CodeClubTeam/ElectricGarden/README.md

# ElectricGarden

The repositories folder includes all of the files and repos that were created as part of the Electric Garden Project. Some folders include depreciated code that was no longer used in the final stage of the product.
