CodeClubTeam/ElectricGarden/Repositories/electricgarden-electricgardenfirmware-3cf1cbd7a6ae/provisioning/README.md

Provisioning for Electric Garden node devices
====================

Before the provision script can be run, Python is required to be installed, with Python 3 being used for most cases. The 'Add to PATH' option should be ticked when installing to allow for scripting.
Upon install and adding python to PATH, the `install.bat` file can be run to install all required modules.

Running the `deploy_node_fast_***_prod.bat` batch file (with *** being either G01 or L01 depending on which device is being provisioned) will begin the provisioning process for a node, if connected via the 6-pin FTDI USB cable.
Once plugged in with the black cable side being aligned with the '\*' symbol on the board, the COM port needs to be found, which can be found on windown devices checking the COM port items in device manager.
Editing the batch file will allow the change of the COM port that is being used if required.

Other arguments in the batch file include:
	
	-k or --key : LoRa Encryption key
	-r or --rom : Firmware ROM image to program
	-i or --image: Software FS image to program
	-c or --copy: Copy files to filesystem instead
	-q or --quiet: Do not show DEBUG messages
	-qq or --silent: Do not show INFO messages
	-qqq or --shutup: Do not show any logging

To change the software that is being installed on to the board, changes need to be made to the `***firmware.gz` file in the `artifacts` folder, where G01 and L01 firmware is separate.

If a device has been created in ThingPark before the provisioning process, the ThingPark reference value will not be returned correctly and the deployer will not add the reference.
In this case, the device can be removed from ThingPark and the process can be started, allowing the reference value to be saved to the database. 
This reference value is used by the ThingPark API to update the individual devices' information, such as the connectivity plan. The connectivity plan is initially set to None, to be changed later in the process when assigned to a user.

The 4-pin FTDI cable can be used to then check if the unit is working correctly. Once plugged in and the serial output is viewed, the normal code should run, connecting to the network and sending a data packet. Failure to connect or send is shown in the output.
