CodeClubTeam/ElectricGarden/Repositories/electricgarden-eg-device-hq-9bbac4f2906a/api/funcs/auditlog-inserter/README.md

# Audit log inserter

Takes messages from the audit log queue and inserts
them into the `auditlog` table.
