CodeClubTeam/ElectricGarden/Repositories/electricgarden-eg-device-hq-9bbac4f2906a/api/funcs/bootups-catm1/README.md

# Bootup (phone home) API

This is used as an http endpoint for catm1 devices on start up
to let us know they are still alive and what version of hardware and firmware they are running.

It sends them onto the event hub for later processing.
