CodeClubTeam/ElectricGarden/Repositories/electricgarden-eg-device-hq-9bbac4f2906a/api/funcs/bootups/README.md

# Bootup Inserter

Takes the bootup messages off the queue and stores them into blob storage for retrieval.
