CodeClubTeam/ElectricGarden/Repositories/electricgarden-eg-device-hq-9bbac4f2906a/api/funcs/counters-catm1/README.md

# Catm1 counters receiver

This is used as an http endpoint for catm1 devices to send their counters when
requested.

## Future work

We need to have a handler that listens to the counters queue and runs same logic
in this handler to persist them.
