CodeClubTeam/ElectricGarden/Repositories/electricgarden-eg-device-hq-9bbac4f2906a/api/funcs/counters-inserter/README.md

# Counters inserter

Takes counters from the countersQueue (will have been fed from both lora and catm1)
and writes them to azure table storage
