CodeClubTeam/ElectricGarden/Repositories/electricgarden-eg-device-hq-9bbac4f2906a/api/funcs/device-default-settings/README.md

# Device Default Settings API

API for retrieving and updating default settings for each device type.
