CodeClubTeam/ElectricGarden/Repositories/electricgarden-eg-device-hq-9bbac4f2906a/api/funcs/error-relay/README.md

# Errors Inserter

This listens to the errors queue, tweaks and sends them on to raygun.
