CodeClubTeam/ElectricGarden/Repositories/electricgarden-eg-device-hq-9bbac4f2906a/api/funcs/errors-catm1/README.md

# Errors API

This is used as an http endpoint for catm1 devices to send their errors when
requested.
