CodeClubTeam/ElectricGarden/Repositories/electricgarden-eg-device-hq-9bbac4f2906a/api/funcs/lora-sendtime/README.md

# Lora Send Time

Process Send Time messages, delivering them to target device via Thing Park.
