CodeClubTeam/ElectricGarden/Repositories/electricgarden-eg-device-hq-9bbac4f2906a/api/funcs/message-pump/README.md

# Message Pump

This handler is purely to take messages off the Event Hub and route them to the appropriate
Azure storage queue for processing.

For samples, it splits them up into one message for each sample
so each is handled independently (e.g. in retries etc).
