CodeClubTeam/ElectricGarden/Repositories/electricgarden-eg-device-hq-9bbac4f2906a/api/funcs/sample-metrics-updater/README.md

# Sample Metrics updater

Takes sample messages from the sample metrics queue
and updates the samplemetrics table accordingly.
