CodeClubTeam/ElectricGarden/Repositories/electricgarden-eg-device-hq-9bbac4f2906a/api/funcs/sample-relay-multi-delivery/README.md

# Sample Relay Multi Delivery

Handle for the multi-delivery queue that simply relays
samples to the endpoint specified in the queue item.

Used for multi-delivery to ensure each sample endpoint is retried independently.
