CodeClubTeam/ElectricGarden/Repositories/electricgarden-eg-device-hq-9bbac4f2906a/api/funcs/sample-relay-settings/README.md

# Sample Relay Settings API

API for retrieving and updating sample relay end point for each device type.
