CodeClubTeam/ElectricGarden/Repositories/electricgarden-eg-device-hq-9bbac4f2906a/api/funcs/counters/post/README.md

# Counters POST API

This used to be for devices to send to but now they send to catm1-counters.

This is more for testing with a nice json payload directly without the queue.
