CodeClubTeam/ElectricGarden/Repositories/electricgarden-eg-app-e531e8d42cab/ui/src/lessons/content/examples/basics/features-example.mdx

---
name: features-example
title: Features Example
level: 90
publish: localdev
locked: false
---

import { Button } from '../../../../atomic-ui';

## Demo Content

Alan's demo activity to show what can be done with content in the publishing platform.

## Markdown Demo

### Unordered List

-   One
-   Yes

### Numbered List

1.  one
2.  two
3.  aefe

### Formatting

**italics**

~~strikethrough~~

### Block quote:

> more text please

### Some code:

```javascript
function myFun() {
    return 2;
}
```

### Table

| col 1 | col 2 | col 3 | col 4 |
| --- | --- | :---: | ---: |
| spindly bike | hairy legs | cold southerly | exposed ridgeline |

---

## Custom Activity Demo

### Button

This is an actual button as used in the Electric Garden app.
If the implementation of that button changes, so will it.

<Button>Click Me!</Button>
<br />

You can use JSX attributes too.

For example, for a disabled button:

<Button disabled>Disabled Button</Button>
