CodeClubTeam/ElectricGarden/Repositories/electricgarden-eg-app-e531e8d42cab/ui/src/lessons/content/term1-kaitiakitanga/2software2/giants-k10-term1/giantst1s10.mdx

---
name: session10
title: Session 10 - Pruning Pumpkins
ordinal: 10
level: 3
type: giants-guide
term: 1
locked: false
publish: production
coverImagePath: ./gcs10.png
# badges:
#     required: Gardener
#     earned:
#         - Growing your first vegetable
---

import {
    MatchingActivity,
    MatchTarget,
    CannedChart,
    Para,
    MultiChoiceActivity,
    Image,
    ImageWithText,
    TextBox,
    Box,
    CollapsablePanel,
    Spreadsheet,
    Captioned,
    Figure,
    RoundImage,
    ImageWithBorder,
    GoogleDocs,
    GoogleSlides,
} from '../../../../activities';

import { Button } from '../../../../../atomic-ui';

import button from './docbutton.png';

##

###

<Figure>
    <h3>
        <b>Session 10 - Slide Deck</b>
    </h3>
</Figure>

<GoogleSlides
    googleId="2PACX-1vTvl3KjYVqWA8ZQ7ycDG64F3sq7TgafGjBnNhHZp_D1JRpGFeFhK0YiiJcIP9lwZc4BXuSqNf1ooUmQ"
    googlePdfId="1cpKZhSiLtOwhcXv2rZReMeaJxxmlKnTLFvNPi9s_w8k"
/>

<Figure>
    <h6>
        Click the <b>three dots</b> for the options menu, and select{' '}
        <b>'Enter Full Screen'</b> to present the lesson slides.
    </h6>
</Figure>

<br />

<hr />

<br />

###

<Figure>
    <h3>
        <b>Session 10 - Teacher Support</b>
    </h3>
</Figure>

<Figure>
    <a
        href={
            'https://docs.google.com/document/d/10E2sda29PJRIBYY-acljywu89zfQ-WiFnE-5OQzYP5k/preview'
        }
        target={'_blank'}
    >
        <ImageWithBorder src={button} />
    </a>
</Figure>

<br />

<Figure>
    <h6>
        Click the <b>button</b> to access the support document with detailed
        comments to guide the delivery of each slide.
    </h6>
</Figure>

<br />
<br />
<br />
