CodeClubTeam/ElectricGarden/Repositories/electricgarden-eg-app-e531e8d42cab/ui/src/lessons/content/term1-kaitiakitanga/7spreadsheets7/giants-k7-term4/giantst4s7.mdx

---
name: session7
title: Session 7 - Input & Output Devices
ordinal: 10
level: 3
type: giants-guide
term: 4
locked: false
publish: production
coverImagePath: ./gcs7.png
# badges:
#     required: Gardener
#     earned:
#         - Growing your first vegetable
---

import {
    MatchingActivity,
    MatchTarget,
    CannedChart,
    Para,
    MultiChoiceActivity,
    Image,
    ImageWithText,
    TextBox,
    Box,
    CollapsablePanel,
    Spreadsheet,
    Captioned,
    Figure,
    RoundImage,
    ImageWithBorder,
    GoogleDocs,
    GoogleSlides,
} from '../../../../activities';

import { Button } from '../../../../../atomic-ui';

import button from './docbutton.png';

##

###

<Figure>
    <h3>
        <b>Session 7 - Slide Deck</b>
    </h3>
</Figure>

<GoogleSlides
    googleId="2PACX-1vTA6bdGAR4tMWHoP6VCvq_hbAEyUsLs-uta6b1jSuEGp_NLDM7FwhtoAPHQvsRGwZikg45cYGUJ9ey6"
    googlePdfId="13H6Q56lZcNqfDS7mGAEvLOPJcg4DNiIz7fthvZUhSUc"
/>

<Figure>
    <h6>
        Click the <b>three dots</b> for the options menu, and select{' '}
        <b>'Enter Full Screen'</b> to present the lesson slides.
    </h6>
</Figure>

<br />

<hr />

<br />

###

<Figure>
    <h3>
        <b>Session 7 - Teacher Support</b>
    </h3>
</Figure>

<Figure>
    <a
        href={
            'https://docs.google.com/document/d/1OH-iBLDivXzNqAnmxr9wgEhzVn8OaUZpP7ohdrzdUG4/preview'
        }
        target={'_blank'}
    >
        <ImageWithBorder src={button} />
    </a>
</Figure>

<br />

<Figure>
    <h6>
        Click the <b>button</b> to access the support document with detailed
        comments to guide the delivery of each slide.
    </h6>
</Figure>

<br />
<br />
<br />
