CodeClubTeam/ElectricGarden/Repositories/electricgarden-eg_hardware_designs-144f18870407/pcb/probe-cable/cable-drawing.pdf

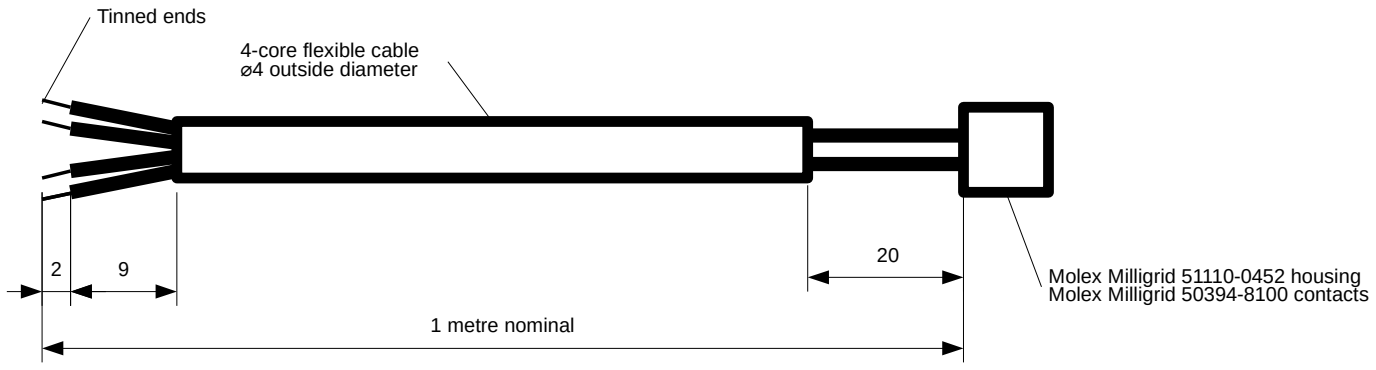
[picture p2: figure]
1 metre nominal; Molex Milligrid 51110-0452 housing Molex Milligrid 50394-8100 contacts; 4-core flexible cable ⌀4 outside diameter; Tinned ends

Electric Garden Probe Cable Specification
Dimensions are mm except where noted Prepared by
Stephen Irons
Brush Technology
2018-08-30
