CodeClubTeam/ElectricGarden/Repositories/electricgarden-eg_node_and_gateway_firmware-aa23058780e1/README.md

# CodeClub HTVG Project

For LoPy devices implementing LoRa, minimum firmware version supported is 1.15.0.b1

# 900MHz Range Increase 
SRD 915-928 MHz

STLs to please move out of 915-921 MHz to allow SRDs

https://www.rsm.govt.nz/about-rsm/spectrum-policy/gazette/gurl/short-range-devices

# Transmission limits
https://gazette.govt.nz/notice/id/2016-go6047

|Band|Max dbW e.i.r.p|Notes|
-|-|-
915-928|0|23
920-928|6|13,23

Note 13. Transmitters using e.i.r.p.s greater than 0 dBW (1 W) must employ frequency hopping or digital modulation techniques.

Note 23. The reference bandwidth for emissions is 100 kHz

# LoRaWAN AU915-928
AU915-928 is the LoRaWAN frequency standard used in Australia and New Zealand.

https://www.thethingsnetwork.org/wiki/LoRaWAN/Frequencies/Frequency-Plans#lorawan-frequencies_au915-928

Uplink:    
916.8 - SF7BW125 to SF10BW125    
917.0 - SF7BW125 to SF10BW125    
917.2 - SF7BW125 to SF10BW125    
917.4 - SF7BW125 to SF10BW125    
917.6 - SF7BW125 to SF10BW125    
917.8 - SF7BW125 to SF10BW125    
918.0 - SF7BW125 to SF10BW125    
918.2 - SF7BW125 to SF10BW125    
917.5 - SF8BW500    
    
Downlink:    
923.3 - SF7BW500 to SF12BW500    
923.9 - SF7BW500 to SF12BW500    
924.5 - SF7BW500 to SF12BW500    
925.1 - SF7BW500 to SF12BW500    
925.7 - SF7BW500 to SF12BW500    
926.3 - SF7BW500 to SF12BW500    
926.9 - SF7BW500 to SF12BW500    
927.5 - SF7BW500 to SF12BW500

This gives us the following unusued channels    
Below Uplink
