CodeClubTeam/ElectricGarden/Repositories/electricgarden-eg-app-e531e8d42cab/shop-ui/src/pages/product/eg-in-garden.jpg

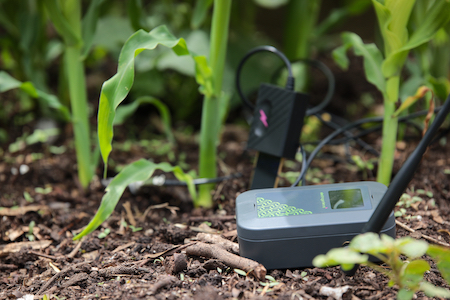
Repositories/electricgarden-eg-app-e531e8d42cab/shop-ui/src/pages/product/eg-in-garden.jpg
