CodeClubTeam/ElectricGarden/Repositories/electricgarden-eg-app-e531e8d42cab/shop-ui/src/pages/product/eg-open-box.jpg

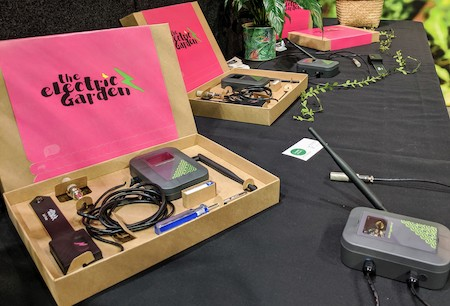
Repositories/electricgarden-eg-app-e531e8d42cab/shop-ui/src/pages/product/eg-open-box.jpg
