CodeClubTeam/ElectricGarden/Repositories/electricgarden-eg_hardware_designs-144f18870407/pcb/housing/TEG_BoxDecal-10_V2-10-10.png

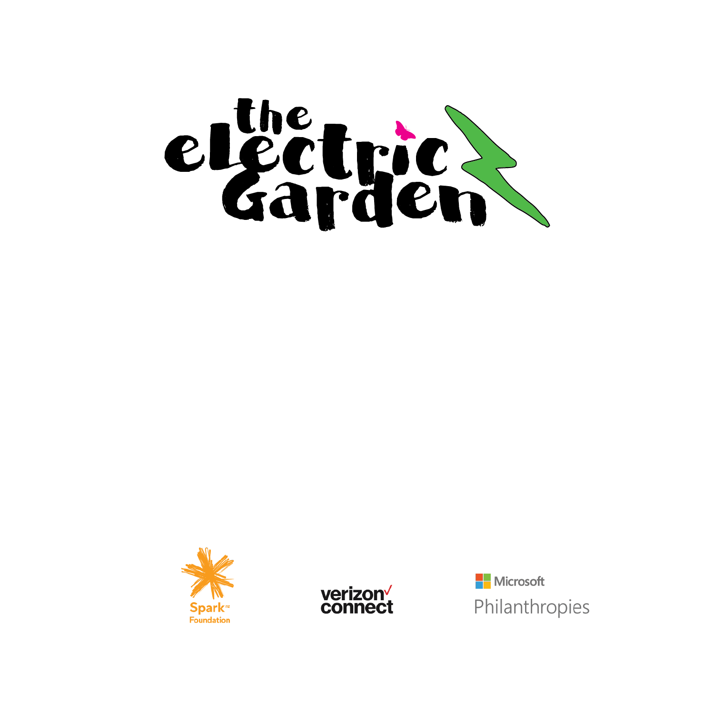
Repositories/electricgarden-eg_hardware_designs-144f18870407/pcb/housing/TEG_BoxDecal-10_V2-10-10.png
