CodeClubTeam/ElectricGarden/Repositories/electricgarden-eg_node_and_gateway_firmware-aa23058780e1/tools/research_development/spectral analysis of LTR329ALS/light-plot.PNG

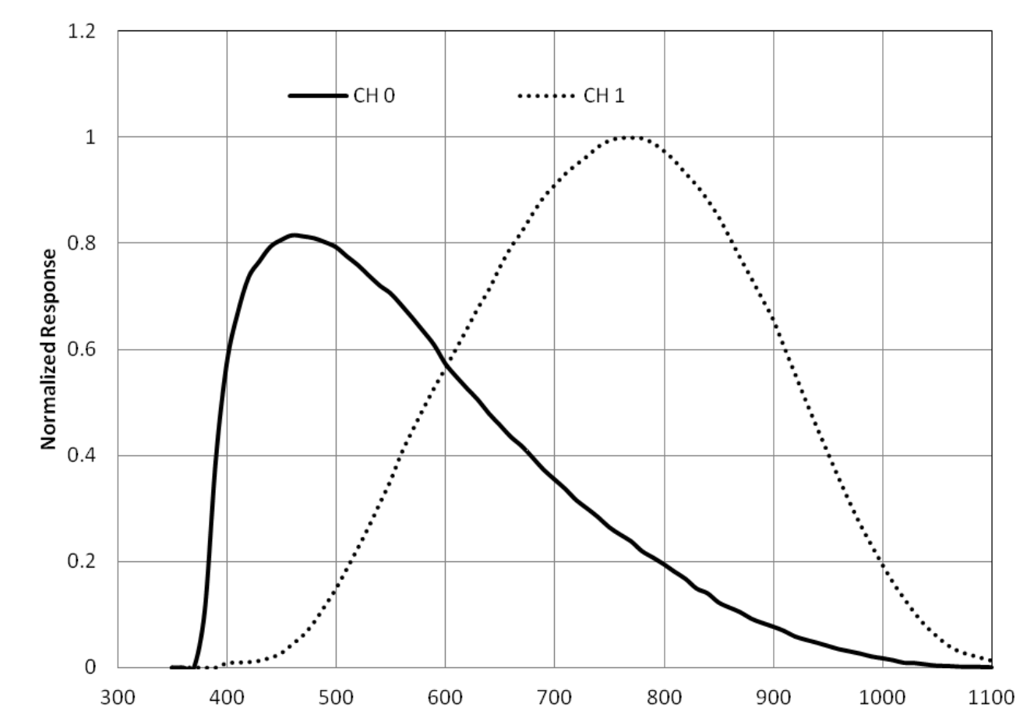
Repositories/electricgarden-eg_node_and_gateway_firmware-aa23058780e1/tools/research_development/spectral analysis of LTR329ALS/light-plot.PNG
