CodeClubTeam/ElectricGarden/Repositories/electricgarden-eg-app-e531e8d42cab/ui/src/lessons/content/examples/chart/chart-example-guide.mdx

---
name: chart-example1
title: Chart Example - Guide
type: facilitation-guide
publish: false
coverImagePath: ./images/chart-cover.png
---

## This is a teacher guide to the Chart Example

Cold wind and rain comes with storms and with that the temperature
drops and the moisture in the soil goes up.

In this lesson your students are encouraged to discover the relationship
between weather conditions and these metrics captured by Electric Garden sensors.
