CodeClubTeam/ElectricGarden/Repositories/electricgarden-eg_hardware_designs-144f18870407/pcb/housing/EG-node-machining.pdf

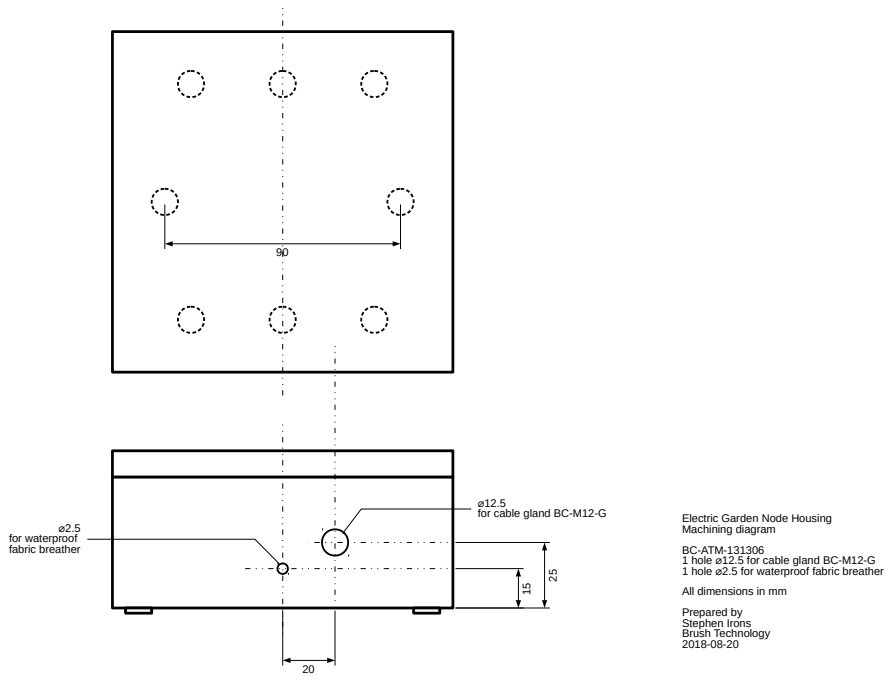
[picture p7: page 1]
⌀2.5 for waterproof fabric breather; for cable gland BC-M12-G; Electric Garden Node Housing

Machining diagram
BC-ATM-131306
1 hole ⌀12.5 for cable gland BC-M12-G
1 hole ⌀2.5 for waterproof fabric breather
All dimensions in mm
Prepared by
Stephen Irons
Brush Technology
