CodeClubTeam/ElectricGarden/Repositories/electricgarden-eg_hardware_designs-144f18870407/pcb/housing/EG-node-printing-black-127x127.pdf

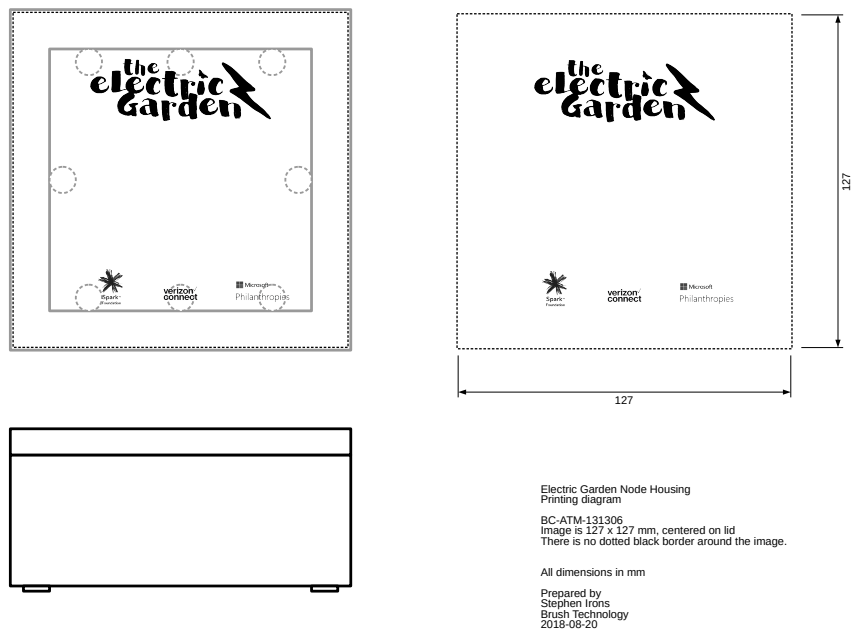
[picture p8: page 1]

Electric Garden Node Housing
Printing diagram
BC-ATM-131306
Image is 127 x 127 mm, centered on lid
There is no dotted black border around the image.

All dimensions in mm
Prepared by
Stephen Irons
Brush Technology
