CodeClubTeam/ElectricGarden/Repositories/electricgarden-eg_hardware_designs-144f18870407/pcb/housing/EG-node-printing.pdf

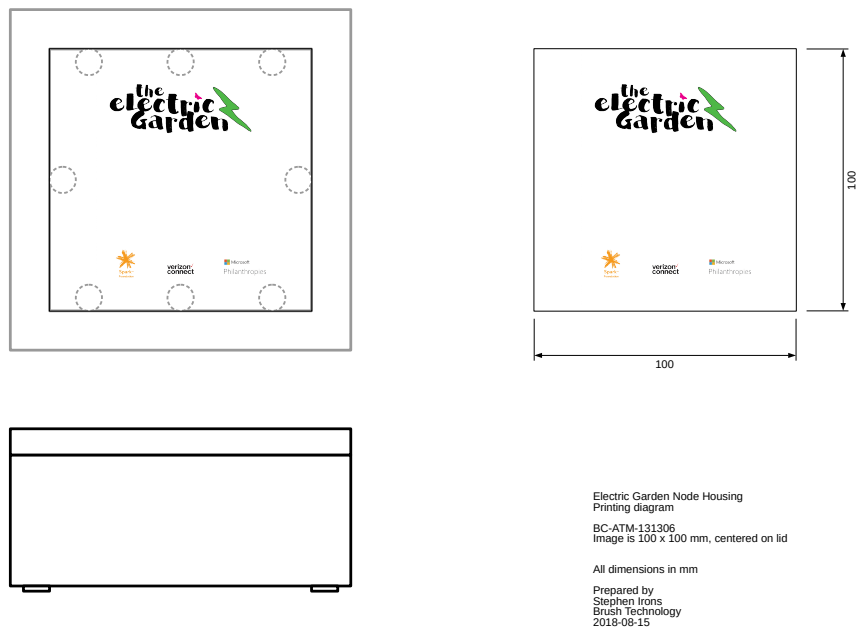
[picture p9: page 1]

Electric Garden Node Housing
Printing diagram
BC-ATM-131306
Image is 100 x 100 mm, centered on lid

All dimensions in mm
Prepared by
Stephen Irons
Brush Technology
