CodeClubTeam/ElectricGarden/Repositories/electricgarden-eg_hardware_designs-144f18870407/pcb/eg_node/v1.1.0/eg_node.pdf

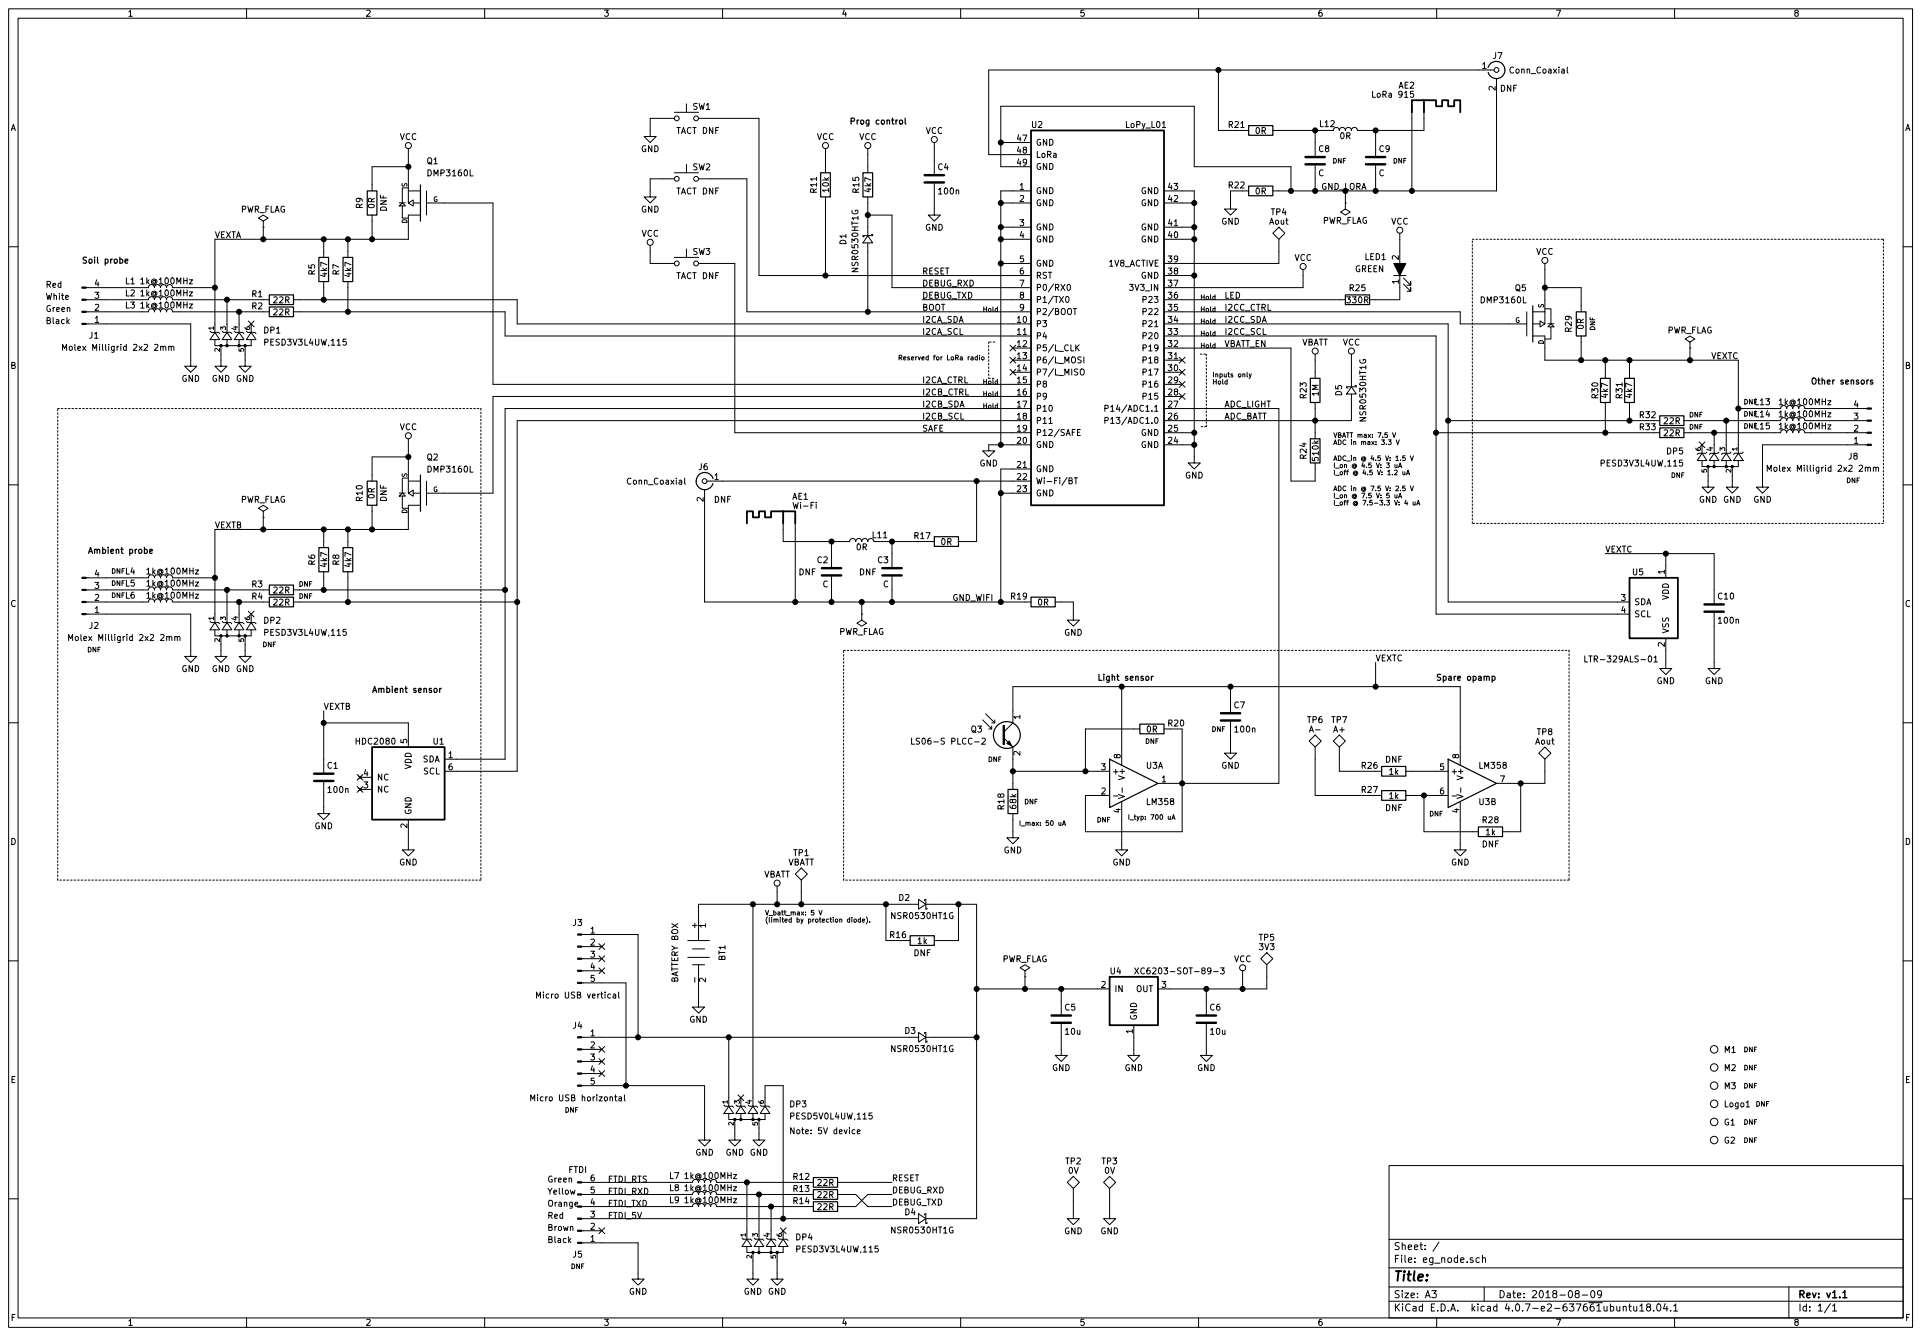
[picture p10: page 1]
