CodeClubTeam/ElectricGarden/Repositories/electricgarden-eg_hardware_designs-144f18870407/pcb/eg_probe/v0.1.4/eg_probe.pdf

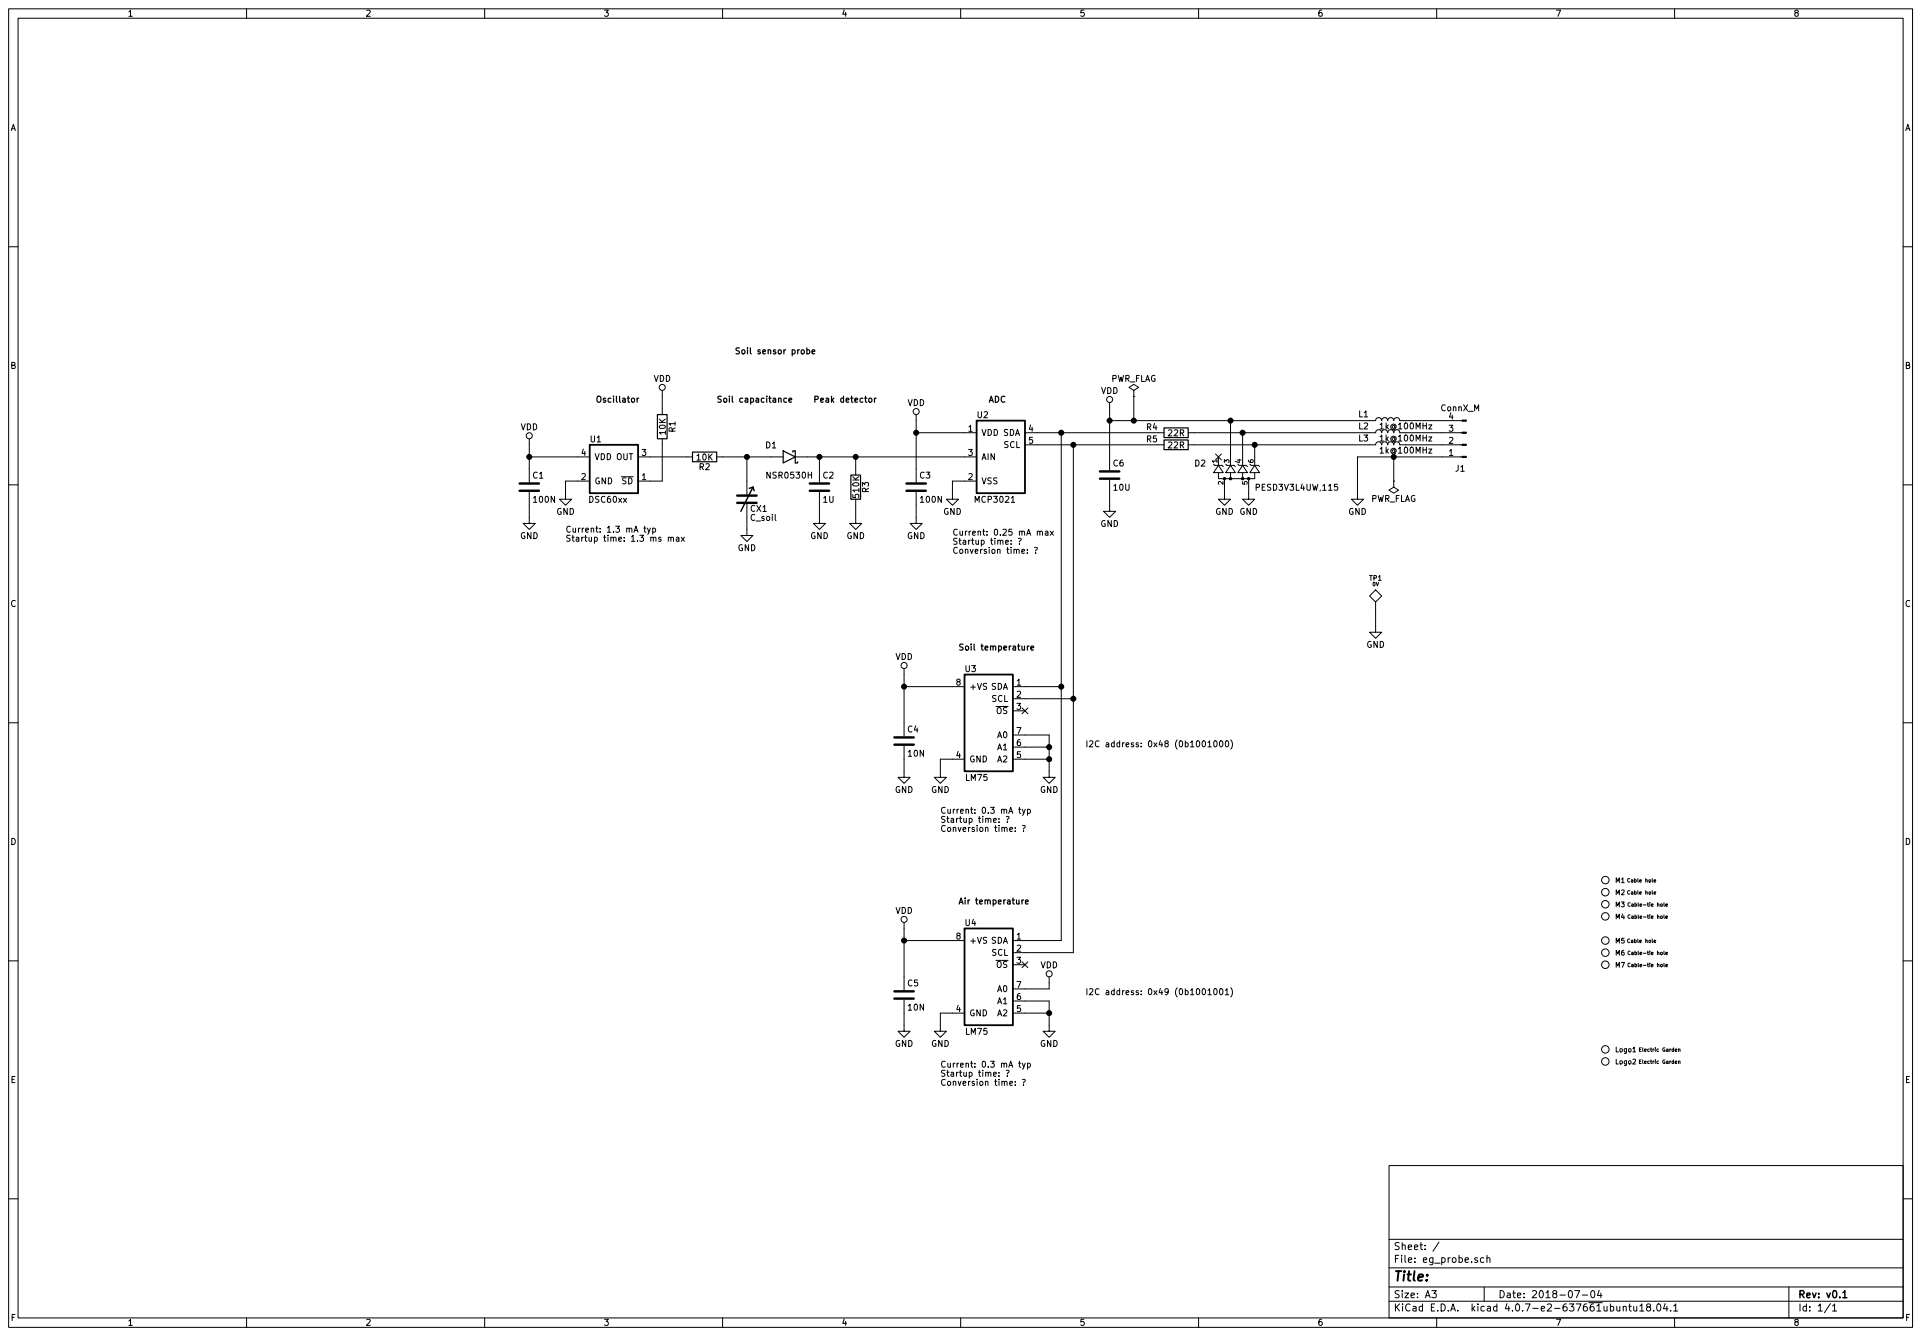
[picture p11: page 1]
