CodeClubTeam/ElectricGarden/Repositories/electricgarden-eg_hardware_designs-144f18870407/pcb/eg_node/v0.3.2/eg_node.pdf

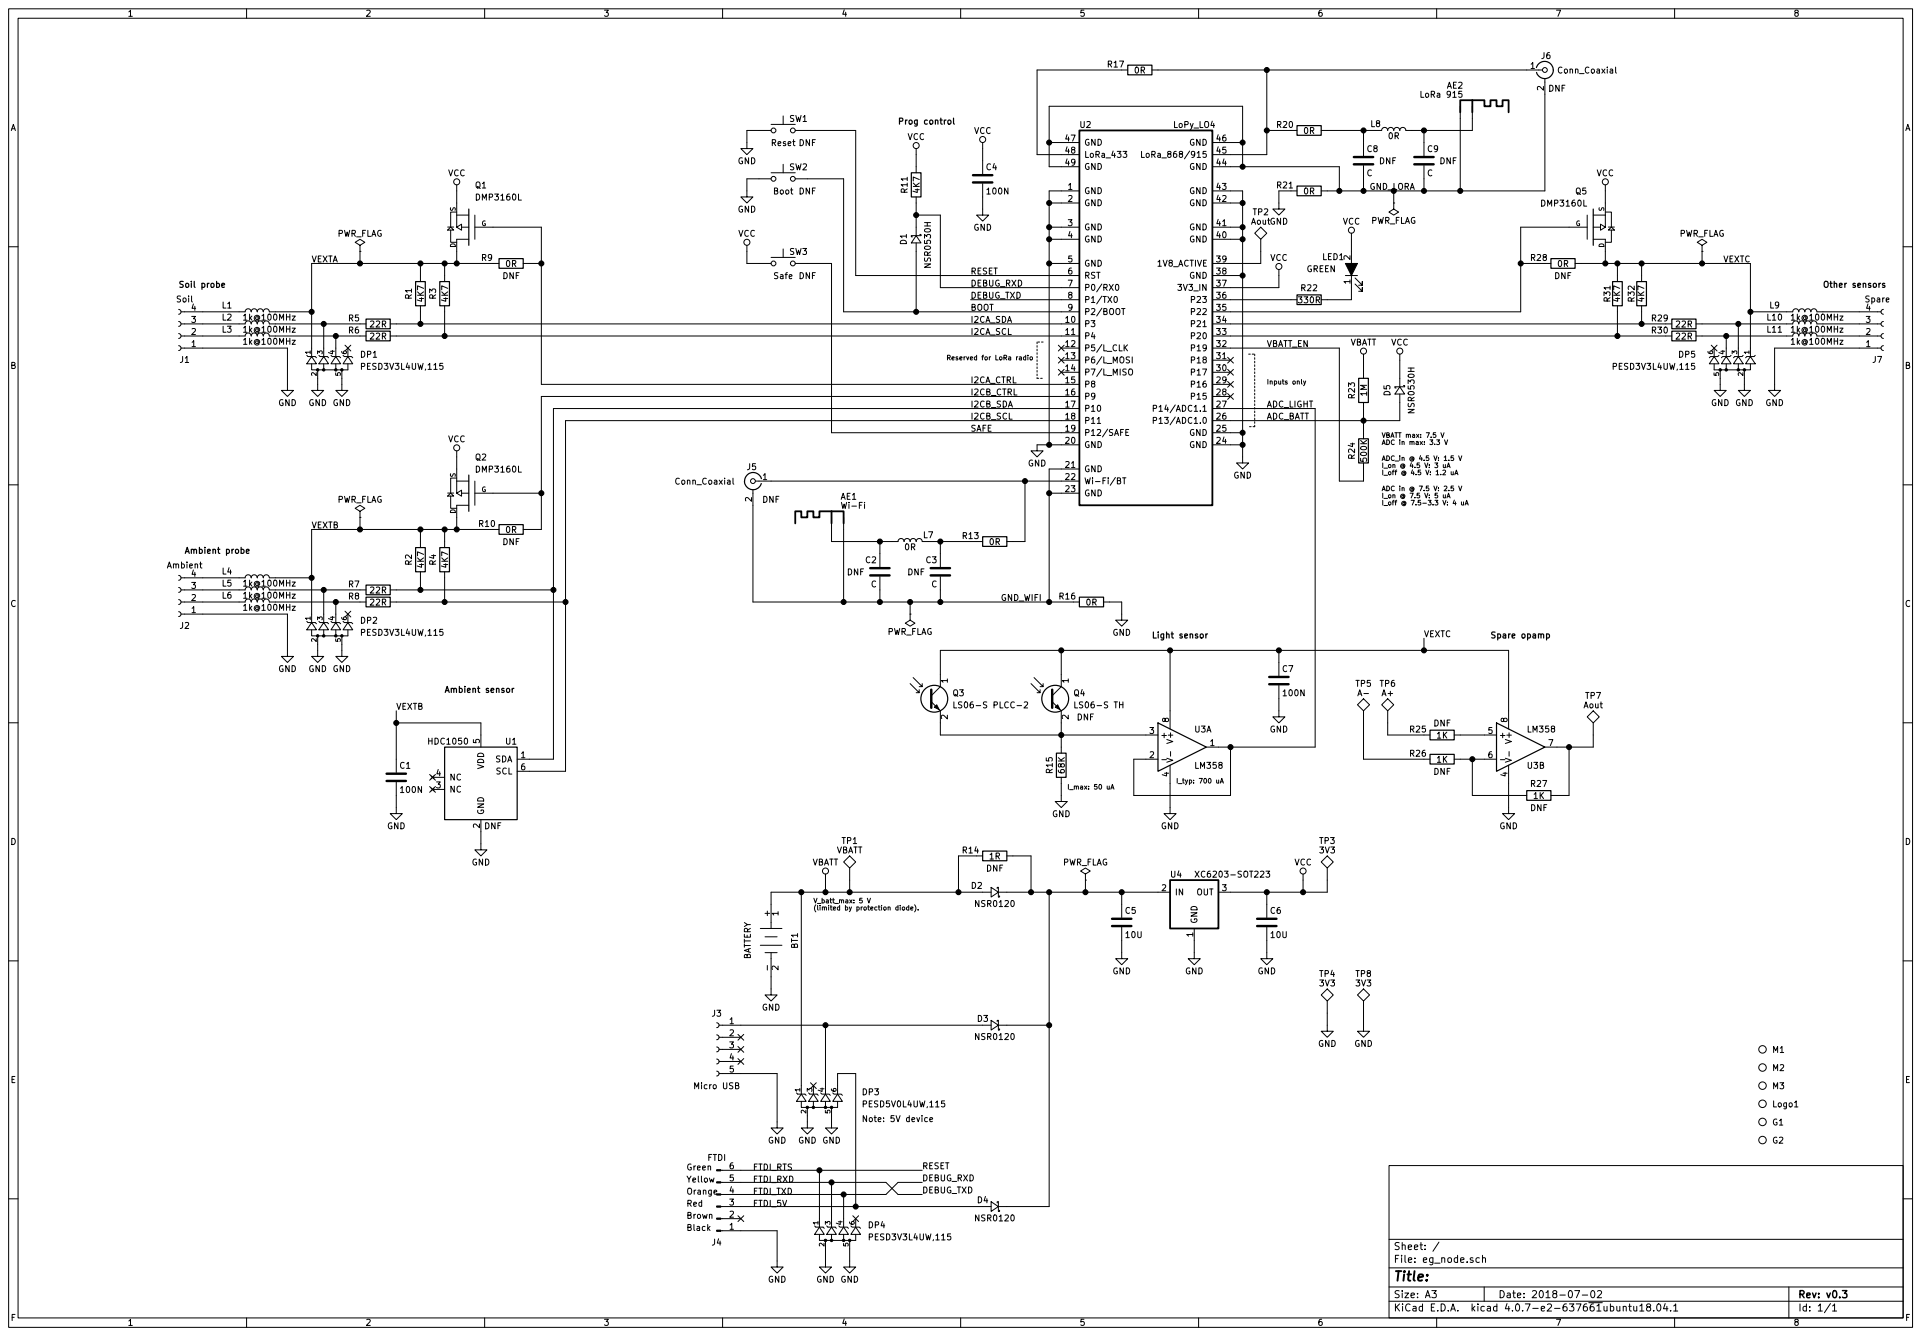
[picture p12: page 1]
