CodeClubTeam/ElectricGarden/Repositories/electricgarden-eg_hardware_designs-144f18870407/pcb/eg_node/eg_node.kicad_pcb

## KiCad design Repositories/electricgarden-eg_hardware_designs-144f18870407/pcb/eg_node/eg_node.kicad_pcb (2023-07-12)

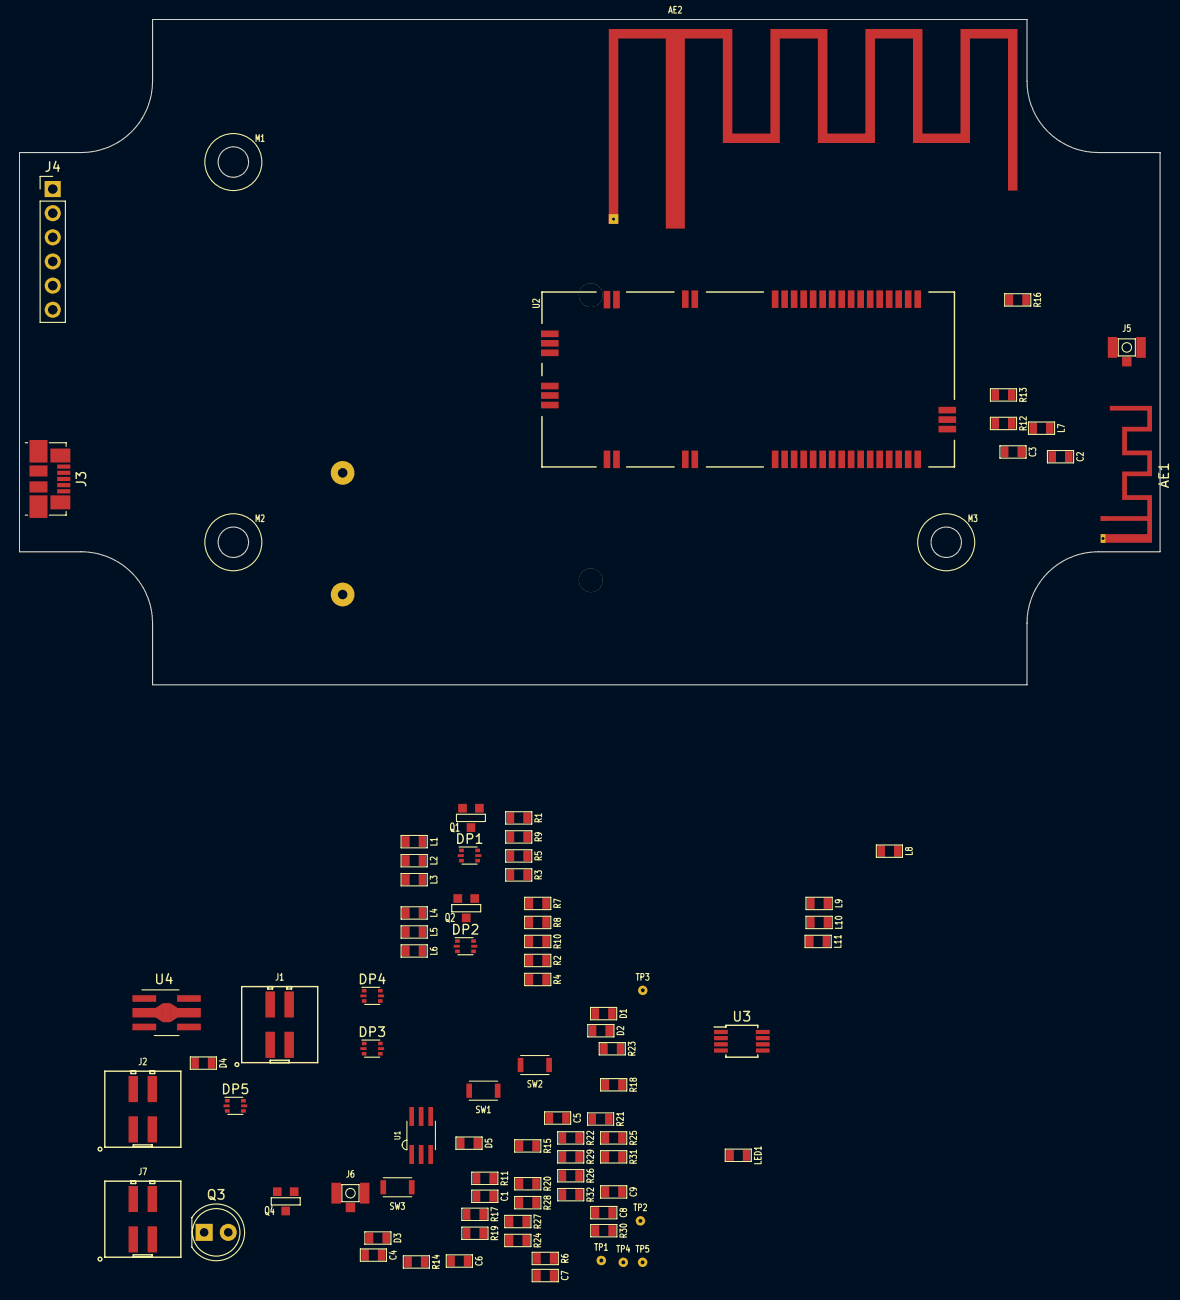
[picture p13: board eg_node.kicad_pcb from above]

Board: 4 copper layers, 120.0 x 70.0 mm, 92 parts (1 on the bottom side), 60 nets, no tracks yet.

Parts:
AE1: Antenna_F; Texas_SWRA117D_2.4GHz_Left
AE2: Antenna_F; Texas_SWRA228C_915MHz_Right
BT1: BATTERY; MPD_BC3AAPC
C1, C4, C7: 100N; SM0603
C2, C3, C8, C9: C; SM0603
C5, C6: 10U; SM0603
D1, D5: NSR0530H; SM0603
D2, D3, D4: NSR0120; SM0603
DP1, DP2, DP4, DP5: UCLAMP3304A; SOT-666
DP3: UCLAMP0504A; SOT-666
J1, J2, J7: ConnX_F; Molex_Milligrid_02x2_2mm
J3: Micro USB; USB_Micro-B_Molex_47346-0001
J4: FTDI; Socket_Strip_Straight_1x06_Pitch2.54mm
J5, J6: Conn_Coaxial; Hirose-U.FL-R-SMT-1(40)
L1, L2, L3, L4, L5, L6, L9, L10, L11: 1k@100MHz; SM0603
L7, L8: 0R; SM0603
LED1: GREEN; SM0603
M1, M2, M3: MOUNT; hole3.2
Q1, Q2, Q4: BSS308PE H6327; SOT23GDS
Q3: LS06-S; LED_D5.0mm
R1, R2, R3, R4, R11, R31, R32: 4K7; SM0603
R5, R6, R7, R8, R29, R30: 22R; SM0603
R9, R10, R12, R13, R16, R17, R18, R19, R20, R21, R28: 0R; SM0603
R14: 1R; SM0603
R15: 68K; SM0603
R22: 330R; SM0603
R23: 1M; SM0603
R24: 500K; SM0603
R25, R26, R27: 1K; SM0603
SW1: Reset; CK_KXT_3xx
SW2: Boot; CK_KXT_3xx
SW3: Safe; CK_KXT_3xx
TP1: VBATT; Testpoint-1mm-TH
TP2: 3V3; Testpoint-1mm-TH
TP3: A-; Testpoint-1mm-TH
TP4: A+; Testpoint-1mm-TH
TP5: Aout; Testpoint-1mm-TH
U1: HDC1050; WSON6
U2: LoPy_LO4; L04_OEM
U3: LM358; MSOP-8_3x3mm_Pitch0.65mm
U4: NCP694-SOT-895; SOT-89-5_Housing_Handsoldering

Connections:
/ADC_BATT: D5.2, R23.2, R24.1, U2.26
/ADC_LIGHT: U2.27, U3.1, U3.2
/BOOT: D1.2, SW2.2, U2.9
/DEBUG_RXD: D1.1, DP4.4, J4.4, R11.2, U2.7
/DEBUG_TXD: DP4.3, J4.5, U2.8
/GND_LORA: AE2.2, C8.2, C9.2, J6.2, R21.1, U2.44, U2.46, U2.47, U2.49
/GND_WIFI: AE1.2, C2.2, C3.2, J5.2, R16.2, U2.21, U2.23
/I2CA_CTRL: Q1.G, R9.1, U2.15
/I2CA_SCL: R6.1, U2.11
/I2CA_SDA: R5.1, U2.10
/I2CB_CTRL: Q2.G, R10.1, U2.16
/I2CB_SCL: R8.1, U1.6, U2.18
/I2CB_SDA: R7.1, U1.1, U2.17
/RESET: DP4.1, J4.6, SW1.2, U2.6
/SAFE: SW3.2, U2.19
/VBATT_EN: R24.2, U2.32
/VEXTA: DP1.1, L1.2, Q1.D, R1.1, R3.1, R9.2
/VEXTB: C1.1, DP2.1, L4.2, Q2.D, R2.1, R4.1, R10.2, U1.5
/VEXTC: C7.1, DP5.1, L9.2, Q3.1, Q4.D, R28.2, R31.1, R32.1, U3.8
GND: BT1.2, C1.2, C4.2, C5.2, C6.2, C7.2, DP1.2, DP1.5, DP2.2, DP2.5, DP3.2, DP3.5, DP4.2, DP4.5, DP5.2, DP5.5, J1.1, J2.1, J3.4, J4.1, J7.1, R15.2, R16.1, R21.2, SW1.1, SW2.1, U1.2, U2.1, U2.2, U2.3, U2.4, U2.5, U2.20, U2.24, U2.25, U2.38, U2.40, U2.41, U2.42, U2.43, U3.4, U4.2
unnamed: AE1.1, C2.1, L7.2
unnamed: AE2.1, C9.1, L8.2
unnamed: C3.1, L7.1, R13.2
unnamed: C5.1, D2.1, D3.1, D4.1, R14.1, U4.3, U4.4
unnamed: C8.1, L8.1, R19.1, R20.1
unnamed: D3.2, DP3.4, J3.1
unnamed: D4.2, DP3.6, J4.3
unnamed: DP1.3, L2.2, R1.2, R5.2
unnamed: DP1.4, L3.2, R3.2, R6.2
unnamed: DP2.3, L5.2, R2.2, R7.2
unnamed: DP2.4, L6.2, R4.2, R8.2
unnamed: DP5.3, L10.2, R29.2, R32.2
unnamed: DP5.4, L11.2, R30.2, R31.2
unnamed: J1.2, L3.1
unnamed: J1.3, L2.1
unnamed: J1.4, L1.1
unnamed: J2.2, L6.1
unnamed: J2.3, L5.1
unnamed: J2.4, L4.1
unnamed: J5.1, R12.2
unnamed: J6.1, R17.1, R18.1
unnamed: J7.2, L11.1
unnamed: J7.3, L10.1
unnamed: J7.4, L9.1
unnamed: LED1.1, R22.1
unnamed: Q3.2, R15.1, U3.3
unnamed: Q4.G, R28.1, U2.35
unnamed: R12.1, R13.1, U2.22
unnamed: R17.2, R19.2, U2.48
unnamed: R18.2, R20.2, U2.45
unnamed: R22.2, U2.36
unnamed: R25.1, U3.5
unnamed: R25.2, TP4.1
unnamed: R26.1, R27.2, U3.6
unnamed: R26.2, TP3.1
unnamed: R27.1, TP5.1, U3.7
unnamed: R29.1, U2.34
unnamed: R30.1, U2.33
VCC: C4.1, C6.1, D5.1, LED1.2, Q1.S, Q2.S, Q4.S, R11.1, SW3.1, TP2.1, U2.37, U4.5
VDD2: BT1.1, D2.2, DP3.1, R14.2, R23.1, TP1.1
