CodeClubTeam/ElectricGarden/Repositories/electricgarden-eg_hardware_designs-144f18870407/pcb/eg_probe/eg_probe.kicad_pcb

## KiCad design Repositories/electricgarden-eg_hardware_designs-144f18870407/pcb/eg_probe/eg_probe.kicad_pcb (2023-07-12)

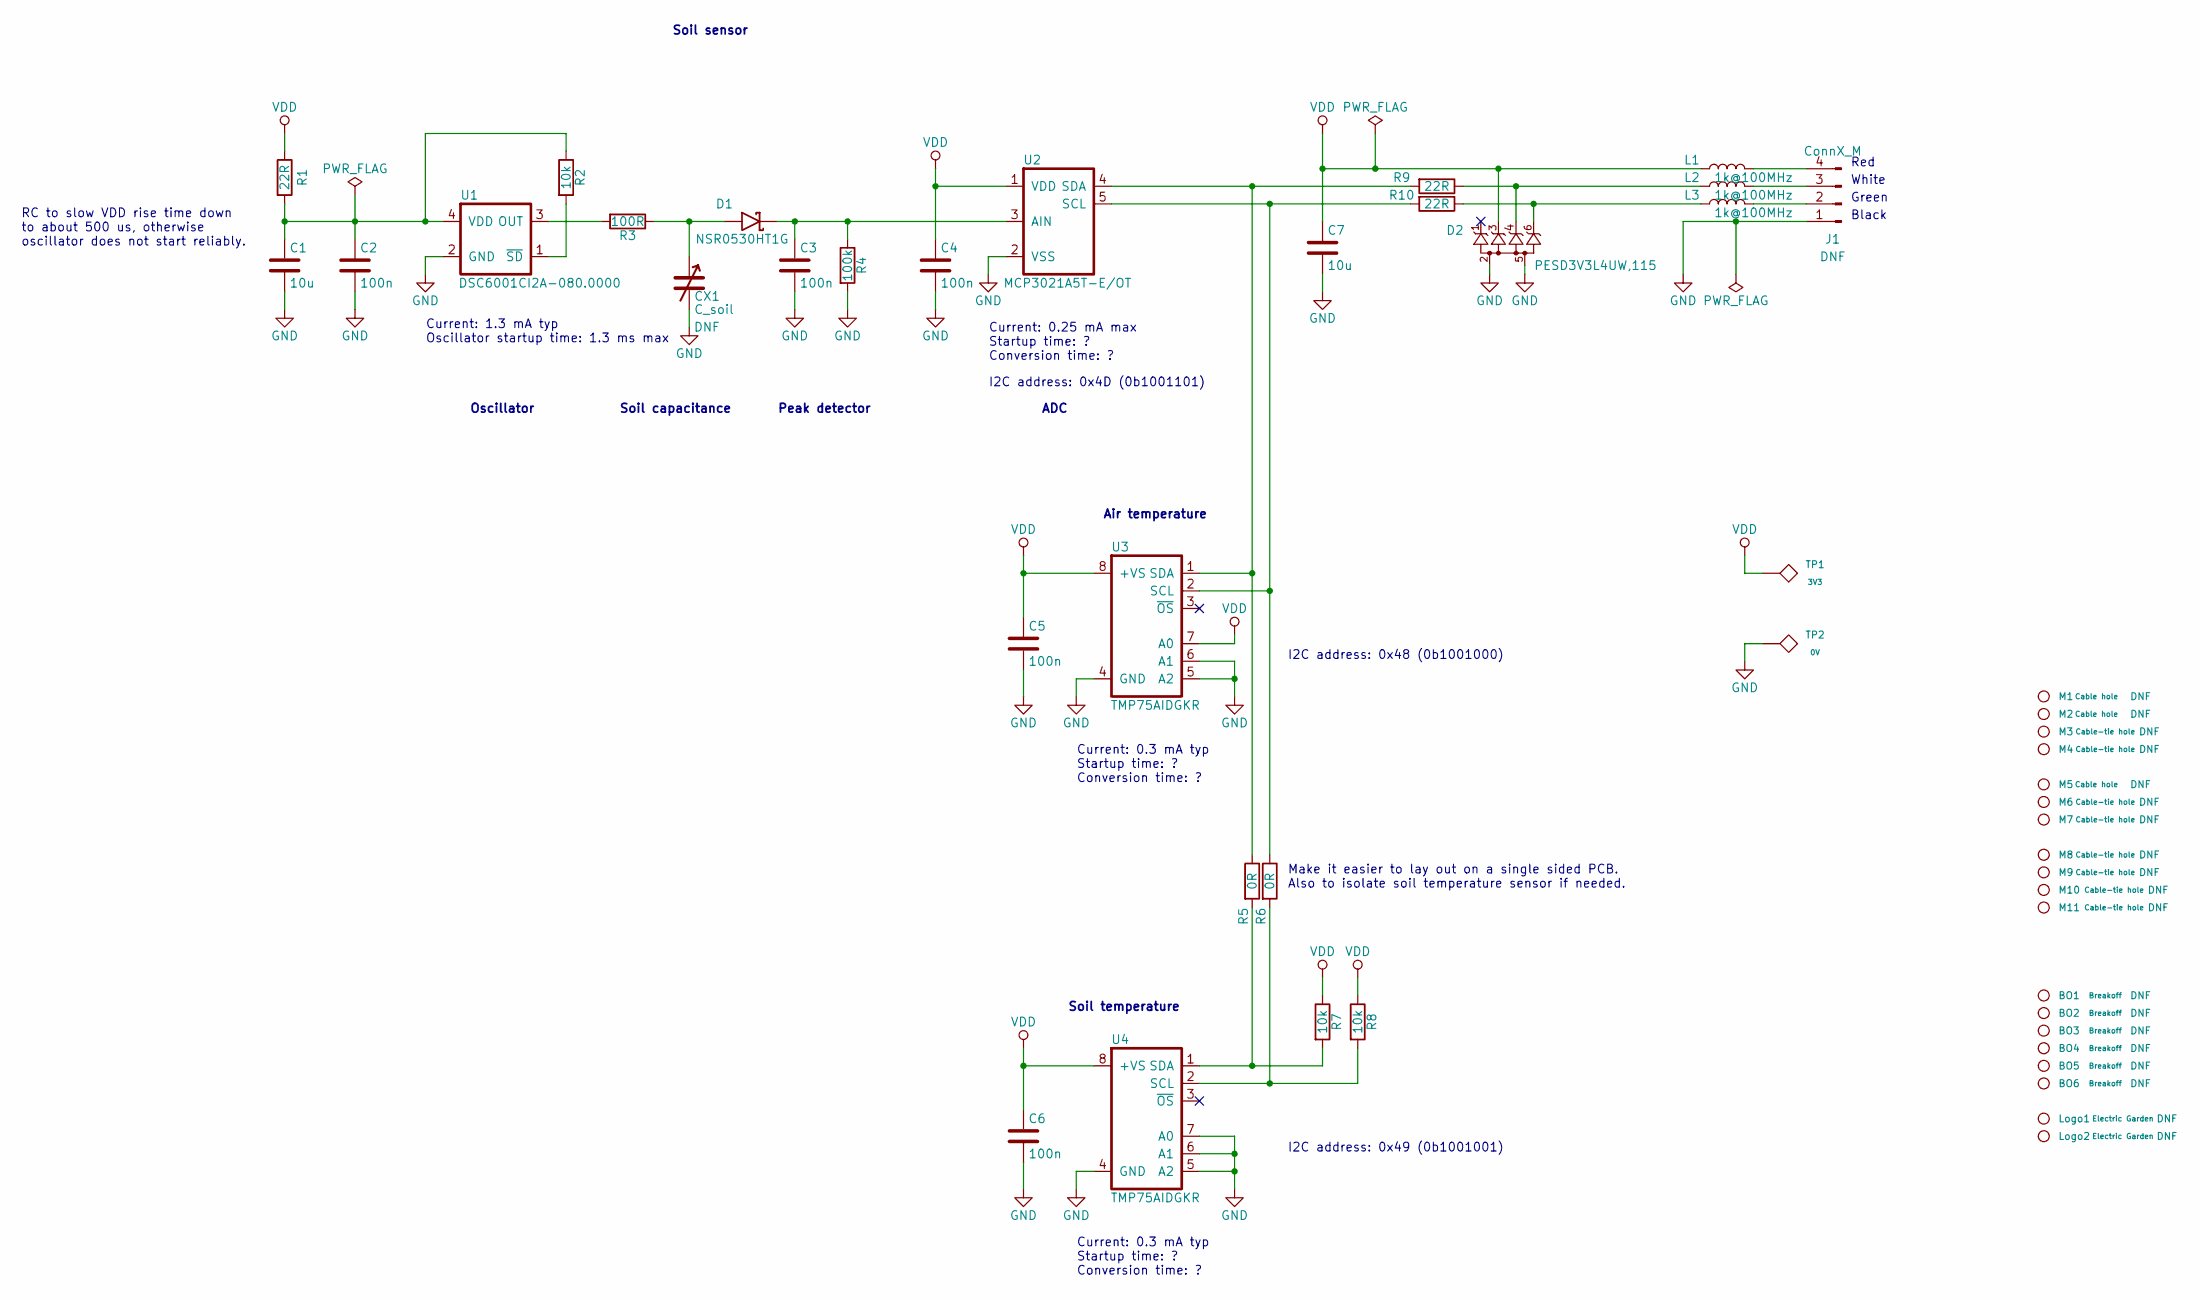
[picture p14: schematic eg_probe.sch]

Parts:
BO1, BO2, BO3, BO4, BO5, BO6: Breakoff; breakoff-2mm
C1, C7: 10u; SM0603
C2, C3, C4, C5, C6: 100n; SM0603
CX1: C_soil; Soil_sensor_capacitive
D1: NSR0530HT1G; D_SOD-323_HandSoldering; Part_number NSR0530HT1G
D2: PESD3V3L4UW,115; SOT-666; Part_number PESD3V3L4UW,115
J1: ConnX_M; CONN_SMD_1x4_big_pad
L1, L2, L3: 1k@100MHz; SM0603; Part_number BLM18AG102SN1D
Logo1: Electric Garden; logo-electric-garden-32x14
Logo2: Electric Garden; logo-electric-garden-25x11
M1, M2, M5: Cable hole; hole4.0
M3, M4, M6, M7, M8, M9, M10, M11: Cable-tie hole; hole3.2
R1, R9, R10: 22R; SM0603
R2, R7, R8: 10k; SM0603
R3: 100R; SM0603
R4: 100k; SM0603
R5, R6: 0R; SM0603
TP1: 3V3; TestPadSquare2.5mm
TP2: 0V; TestPadSquare2.5mm
U1: DSC6001CI2A-080.0000; DFN_4_32x25; Part_number DSC6001CI2A-080.0000
U2: MCP3021A5T-E/OT; SOT-23-5_HandSoldering; Part_number MCP3021A5T-E/OT
U3, U4: TMP75AIDGKR; S-PDSO-G8; Part_number TMP75AIDGKR

Connections:
GND: C1.2, C2.2, C3.2, C4.2, C5.2, C6.2, C7.2, CX1.2, D2.2, D2.5, J1.1, R4.2, TP2.1, U1.2 (GND), U2.2 (VSS), U3.4 (GND), U3.5 (A2), U3.6 (A1), U4.4 (GND), U4.5 (A2), U4.6 (A1), U4.7 (A0)
unnamed: C1.1, C2.1, R1.2, R2.1, U1.4 (VDD)
unnamed: C3.1, D1.2, R4.1, U2.3 (AIN)
unnamed: CX1.1, D1.1, R3.1
unnamed: D2.4, L2.1, R9.1
unnamed: D2.6, L3.1, R10.1
unnamed: J1.2, L3.2
unnamed: J1.3, L2.2
unnamed: J1.4, L1.2
unnamed: R2.2, U1.1 (~SD)
unnamed: R3.2, U1.3 (OUT)
unnamed: R5.1, R9.2, U2.4 (SDA), U3.1 (SDA)
unnamed: R5.2, R7.2, U4.1 (SDA)
unnamed: R6.2, R8.2, U4.2 (SCL)
unnamed: R6.1, R10.2, U2.5 (SCL), U3.2 (SCL)
VDD: C4.1, C5.1, C6.1, C7.1, D2.3, L1.1, R1.1, R7.1, R8.1, TP1.1, U2.1 (VDD), U3.7 (A0), U3.8 (+VS), U4.8 (+VS)

Notes on the sheet:
Peak detector
Soil capacitance
Oscillator
Soil sensor
Current: 1.3 mA typ Oscillator startup time: 1.3 ms max
ADC
Current: 0.25 mA max Startup time: ? Conversion time: ?
Air temperature
Current: 0.3 mA typ Startup time: ? Conversion time: ?
I2C address: 0x49 (0b1001001)
Red
White
Green
Black
Soil temperature
I2C address: 0x48 (0b1001000)
RC to slow VDD rise time down to about 500 us, otherwise oscillator does not start reliably.
Make it easier to lay out on a single sided PCB. Also to isolate soil temperature sensor if needed.
I2C address: 0x4D (0b1001101)

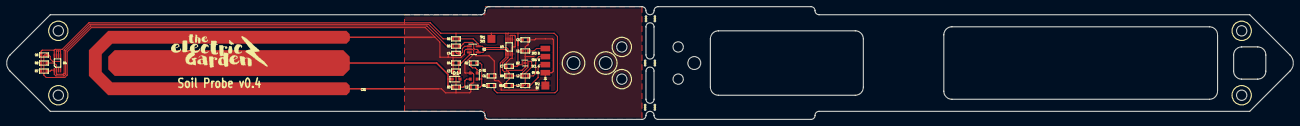
[picture p15: board eg_probe.kicad_pcb from above]

Board: 2 copper layers, 399.6 x 35.0 mm, 49 parts (4 on the bottom side), 16 nets.
