CodeClubTeam/ElectricGarden/Repositories/electricgarden-eg_hardware_designs-144f18870407/pcb/eg_node/eg_node+boxco-1313.kicad_pcb

## KiCad design Repositories/electricgarden-eg_hardware_designs-144f18870407/pcb/eg_node/eg_node+boxco-1313.kicad_pcb (2023-07-12)

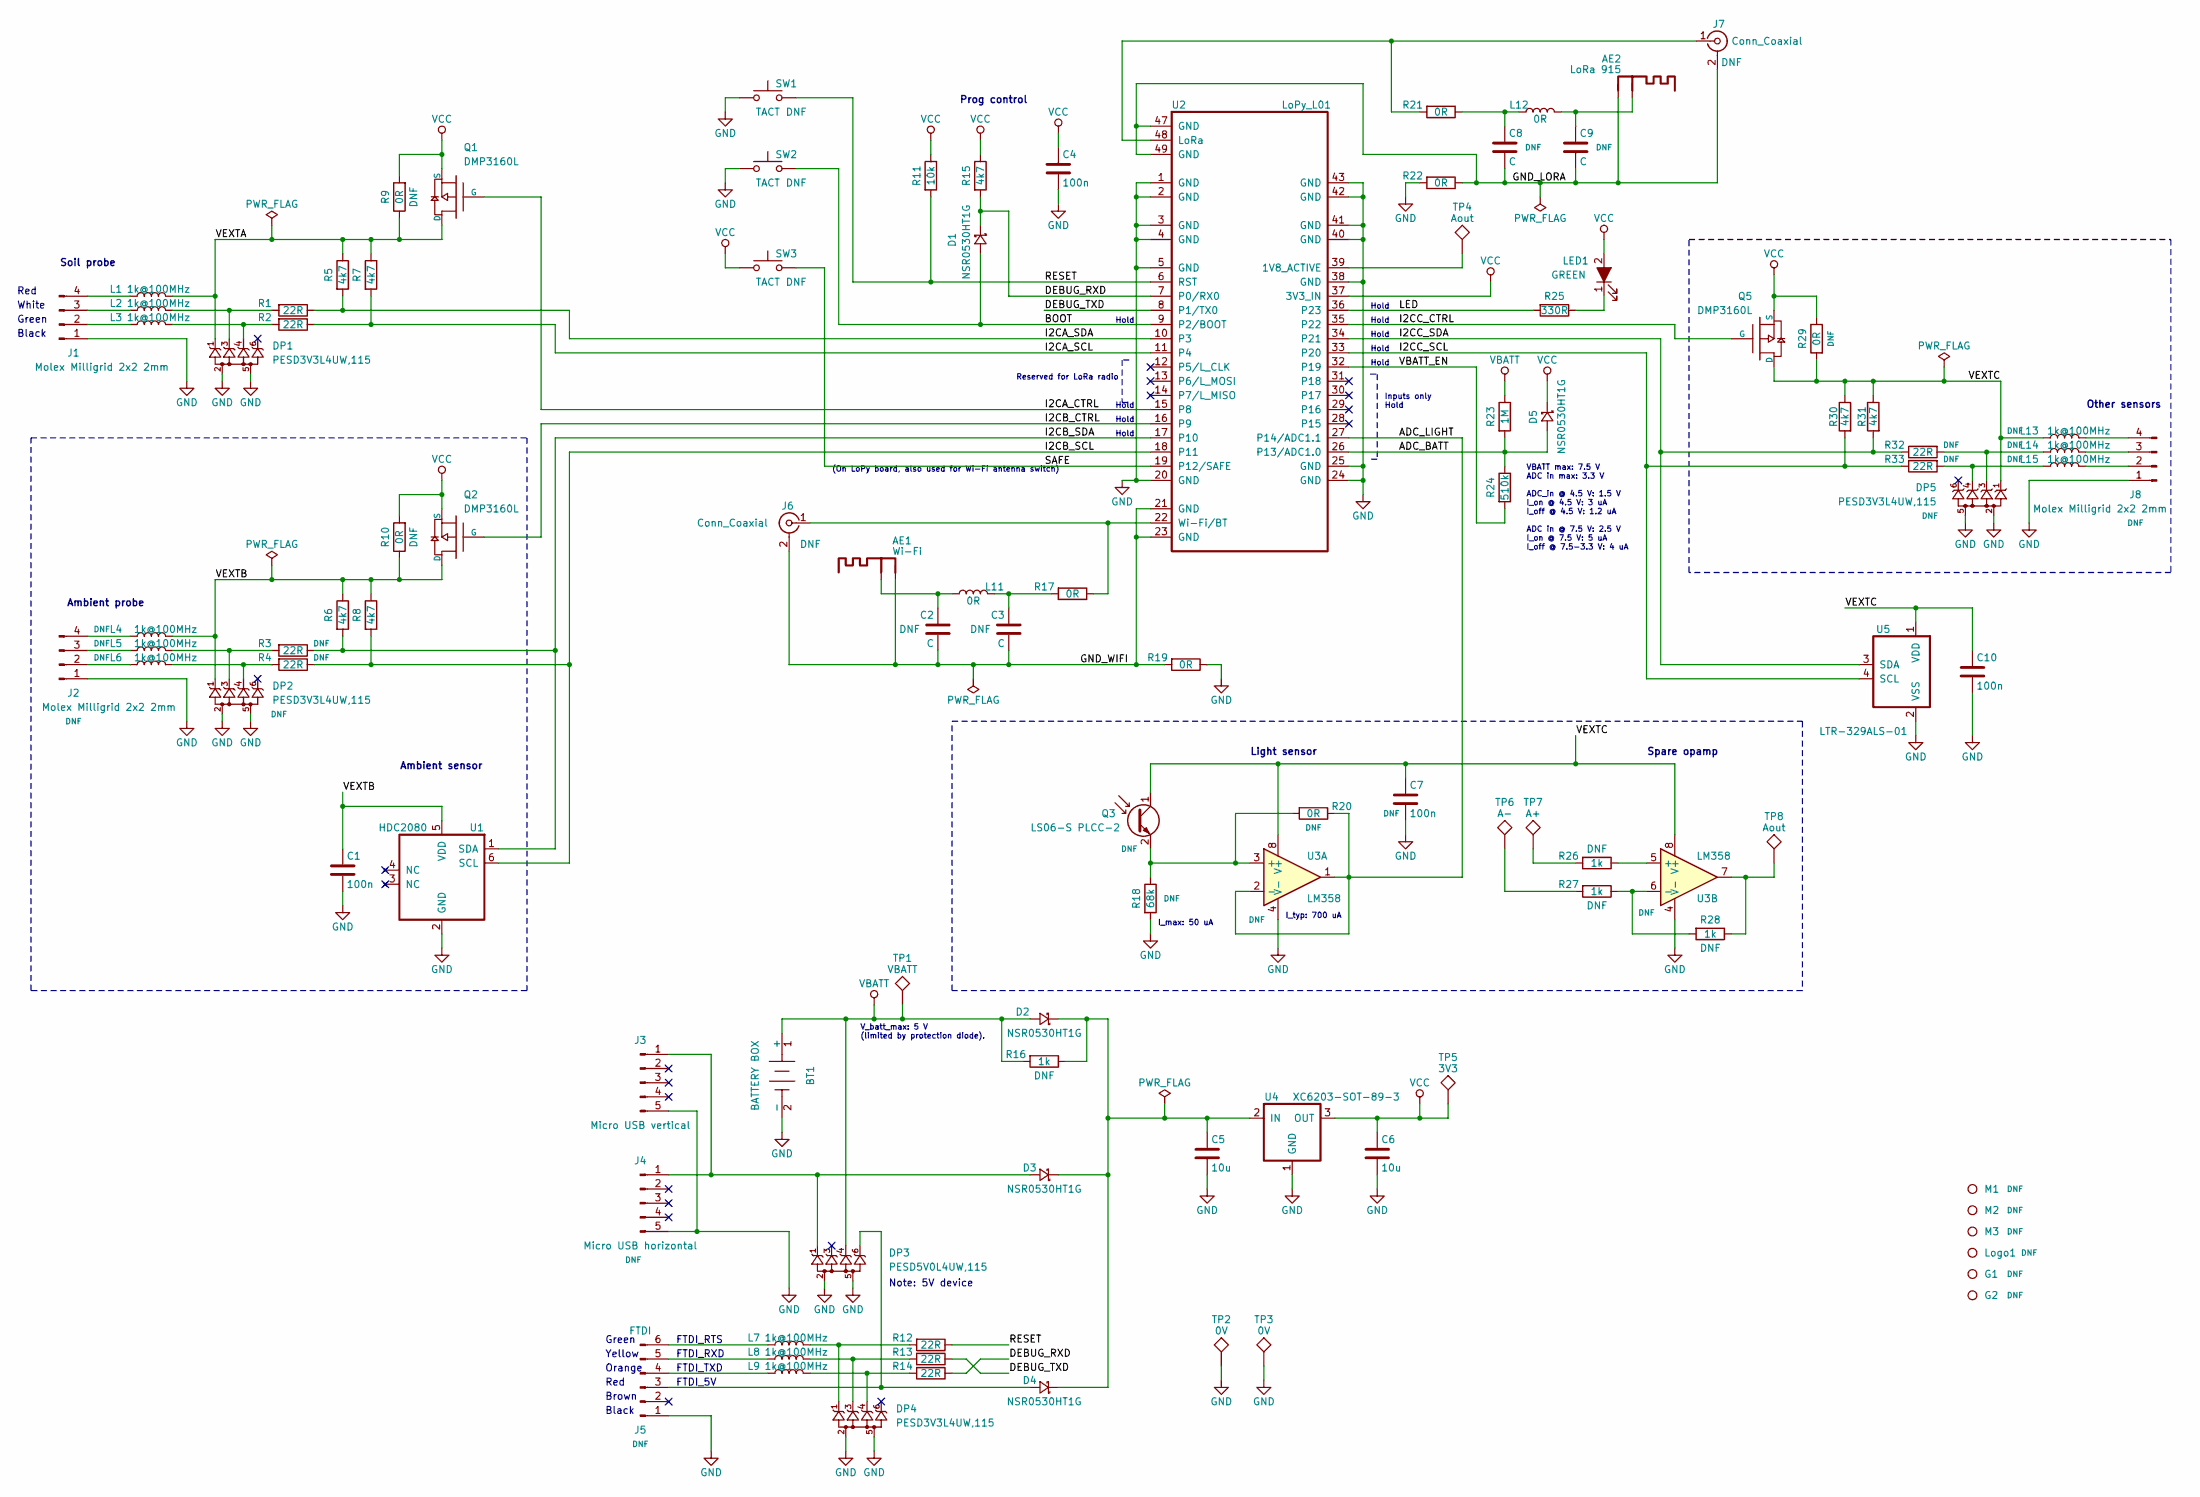
[picture p16: schematic eg_node.sch]

Parts:
AE1: Wi-Fi; Texas_SWRA117D_2.4GHz_Right
AE2: LoRa 915; Texas_SWRA228C_915MHz_Right
BT1: BATTERY BOX; MPD_BC3AAPC; Part_number BC3AAPC
C1, C4, C7, C10: 100n; SM0603
C2, C3, C8, C9: C; SM0603
C5, C6: 10u; SM0603
D1, D2, D3, D4, D5: NSR0530HT1G; D_SOD-323_HandSoldering; Part_number NSR0530HT1G
DP1, DP2, DP4, DP5: PESD3V3L4UW,115; SOT-666; Part_number PESD3V3L4UW,115
DP3: PESD5V0L4UW,115; SOT-666; Part_number PESD5V0L4UW,115
G1, G2: MOUNT; Boxco-gland
J1, J2, J8: Molex Milligrid 2x2 2mm; Molex_Milligrid_02x2_2mm; Part_number 87832-0406
J3: Micro USB vertical; USB_Micro-B_Vertical_Molex-105133-0001; Part_number 105133-0001
J4: Micro USB horizontal; USB_Micro-B_Molex-105017-0001; Part_number 105017-0001
J5: FTDI; Socket_Strip_Straight_1x06_Pitch2.54mm
J6, J7: Conn_Coaxial; Hirose-U.FL-R-SMT-1(40)
L1, L2, L3, L4, L5, L6, L7, L8, L9, L13, L14, L15: 1k@100MHz; SM0603; Part_number BLM18AG102SN1D
L11, L12: 0R; SM0603
LED1: GREEN; LED-0603; Part_number APT1608SGC
Logo1: Logo; logo-electric-garden-32x14
M1, M2, M3: MOUNT; hole4.5
Q1, Q2, Q5: DMP3160L; SOT23GDS; Part_number DMP3160L-7
Q3: LS06-S PLCC-2; LED_PLCC-2
R1, R2, R3, R4, R12, R13, R14, R32, R33: 22R; SM0603
R5, R6, R7, R8, R15, R30, R31: 4k7; SM0603
R9, R10, R17, R19, R20, R21, R22, R29: 0R; SM0603
R11: 10k; SM0603
R16, R26, R27, R28: 1k; SM0603
R18: 68k; SM0603
R23: 1M; SM0603
R24: 510k; SM0603
R25: 330R; SM0603
SW1, SW2, SW3: TACT; CK_KXT_3xx; Part_number KXT 331 LHS
TP1: VBATT; Testpoint-1mm-TH
TP2, TP3: 0V; scope3.5
TP4, TP8: Aout; Testpoint-1mm-TH
TP5: 3V3; Testpoint-1mm-TH
TP6: A-; Testpoint-1mm-TH
TP7: A+; Testpoint-1mm-TH
U1: HDC2080; WSON6; Part_number HDC2080DMBT
U2: LoPy_L01; LoPy_L01_OEM; Part_number L01 OEM Module
U3: LM358; MSOP-8_3x3mm_Pitch0.65mm
U4: XC6203-SOT-89-3; SOT-89-3_Handsoldering; Part_number XC6203P332PR-G
U5: LTR-329ALS-01; 4-pin-chipled; Part_number LTR-329ALS-01

Connections:
/ADC_BATT: D5.2 (A), R23.2, R24.1, U2.26 (P13/ADC1.0)
/ADC_LIGHT: R20.1, U2.27 (P14/ADC1.1), U3.1, U3.2 (-)
/BOOT: D1.2 (A), SW2.2, U2.9 (P2/BOOT)
/DEBUG_RXD: D1.1 (K), R14.1, R15.2, U2.7 (P0/RX0)
/DEBUG_TXD: R13.1, U2.8 (P1/TX0)
/GND_LORA: AE2.2 (GND), C8.2, C9.2, J7.2 (Ext), R22.1, U2.47 (GND), U2.49 (GND)
/GND_WIFI: AE1.2 (GND), C2.2, C3.2, J6.2 (Ext), R19.2, U2.21 (GND), U2.23 (GND)
/I2CA_CTRL: Q1.G, U2.15 (P8)
/I2CA_SCL: R2.1, R7.2, U2.11 (P4)
/I2CA_SDA: R1.1, R5.2, U2.10 (P3)
/I2CB_CTRL: Q2.G, U2.16 (P9)
/I2CB_SCL: R4.1, R8.2, U1.6 (SCL), U2.18 (P11)
/I2CB_SDA: R3.1, R6.2, U1.1 (SDA), U2.17 (P10)
/I2CC_CTRL: Q5.G, U2.35 (P22)
/I2CC_SCL: R30.2, R33.1, U2.33 (P20), U5.4 (SCL)
/I2CC_SDA: R31.2, R32.1, U2.34 (P21), U5.3 (SDA)
/LED: R25.2, U2.36 (P23)
/RESET: R11.2, R12.1, SW1.2, U2.6 (RST)
/SAFE: SW3.2, U2.19 (P12/SAFE)
/VBATT_EN: R24.2, U2.32 (P19)
/VEXTA: DP1.1, L1.2, Q1.D, R5.1, R7.1, R9.1
/VEXTB: C1.1, DP2.1, L4.2, Q2.D, R6.1, R8.1, R10.1, U1.5 (VDD)
/VEXTC: C7.1, C10.1, DP5.1, L13.2, Q3.1 (C), Q5.D, R29.2, R30.1, R31.1, U3.8 (V+), U5.1 (VDD)
GND: BT1.2 (-), C1.2, C4.2, C5.2, C6.2, C7.2, C10.2, DP1.2, DP1.5, DP2.2, DP2.5, DP3.2, DP3.5, DP4.2, DP4.5, DP5.2, DP5.5, J1.1, J2.1, J3.5, J4.5, J5.1, J8.1, R18.2, R19.1, R22.2, SW1.1, SW2.1, TP2.1, TP3.1, U1.2 (GND), U2.1 (GND), U2.2 (GND), U2.3 (GND), U2.4 (GND), U2.5 (GND), U2.20 (GND), U2.24 (GND), U2.25 (GND), U2.38 (GND), U2.40 (GND), U2.41 (GND), U2.42 (GND), U2.43 (GND), U3.4 (V-), U4.1 (GND), U5.2 (VSS)
unnamed: AE1.1 (A), C2.1, L11.2
unnamed: AE2.1 (A), C9.1, L12.2
unnamed: C3.1, L11.1, R17.2
unnamed: C5.1, D2.1 (K), D3.1 (K), D4.1 (K), R16.1, U4.2 (IN)
unnamed: C8.1, L12.1, R21.1
unnamed: D3.2 (A), DP3.1, J3.1, J4.1
unnamed: D4.2 (A), DP3.6, J5.3
unnamed: DP1.3, L2.2, R1.2
unnamed: DP1.4, L3.2, R2.2
unnamed: DP2.3, L5.2, R3.2
unnamed: DP2.4, L6.2, R4.2
unnamed: DP4.1, L7.2, R12.2
unnamed: DP4.3, L8.2, R13.2
unnamed: DP4.4, L9.2, R14.2
unnamed: DP5.3, L14.2, R32.2
unnamed: DP5.4, L15.2, R33.2
unnamed: J1.2, L3.1
unnamed: J1.3, L2.1
unnamed: J1.4, L1.1
unnamed: J2.2, L6.1
unnamed: J2.3, L5.1
unnamed: J2.4, L4.1
unnamed: J5.4, L9.1
unnamed: J5.5, L8.1
unnamed: J5.6, L7.1
unnamed: J6.1 (In), R17.1, U2.22 (Wi-Fi/BT)
unnamed: J7.1 (In), R21.2, U2.48 (LoRa)
unnamed: J8.2, L15.1
unnamed: J8.3, L14.1
unnamed: J8.4, L13.1
unnamed: LED1.1 (K), R25.1
unnamed: Q3.2 (E), R18.1, R20.2, U3.3 (+)
unnamed: R26.1, U3.5 (+)
unnamed: R26.2, TP7.1
unnamed: R27.1, R28.2, U3.6 (-)
unnamed: R27.2, TP6.1
unnamed: R28.1, TP8.1, U3.7
unnamed: TP4.1, U2.39 (1V8_ACTIVE)
VCC: C4.1, C6.1, D5.1 (K), LED1.2 (A), Q1.S, Q2.S, Q5.S, R9.2, R10.2, R11.1, R15.1, R29.1, SW3.1, TP5.1, U2.37 (3V3_IN), U4.3 (OUT)
VDD2: BT1.1 (+), D2.2 (A), DP3.4, R16.2, R23.1, TP1.1

Notes on the sheet:
Light sensor
Spare opamp
Black
Brown
Red
Orange
Yellow
Green
Ambient sensor
Reserved for LoRa radio
Inputs only Hold
Prog control
FTDI_RTS
FTDI_RXD
FTDI_TXD
FTDI_5V
VBATT max: 7.5 V ADC in max: 3.3 V
Soil probe
Ambient probe
Other sensors
I_max: 50 uA
I_typ: 700 uA
ADC_in @ 4.5 V: 1.5 V I_on @ 4.5 V: 3 uA I_off @ 4.5 V: 1.2 uA
ADC in @ 7.5 V: 2.5 V I_on @ 7.5 V: 5 uA I_off @ 7.5-3.3 V: 4 uA
Note: 5V device
V_batt_max: 5 V (limited by protection diode).
White
Hold
(On LoPy board, also used for Wi-Fi antenna switch)

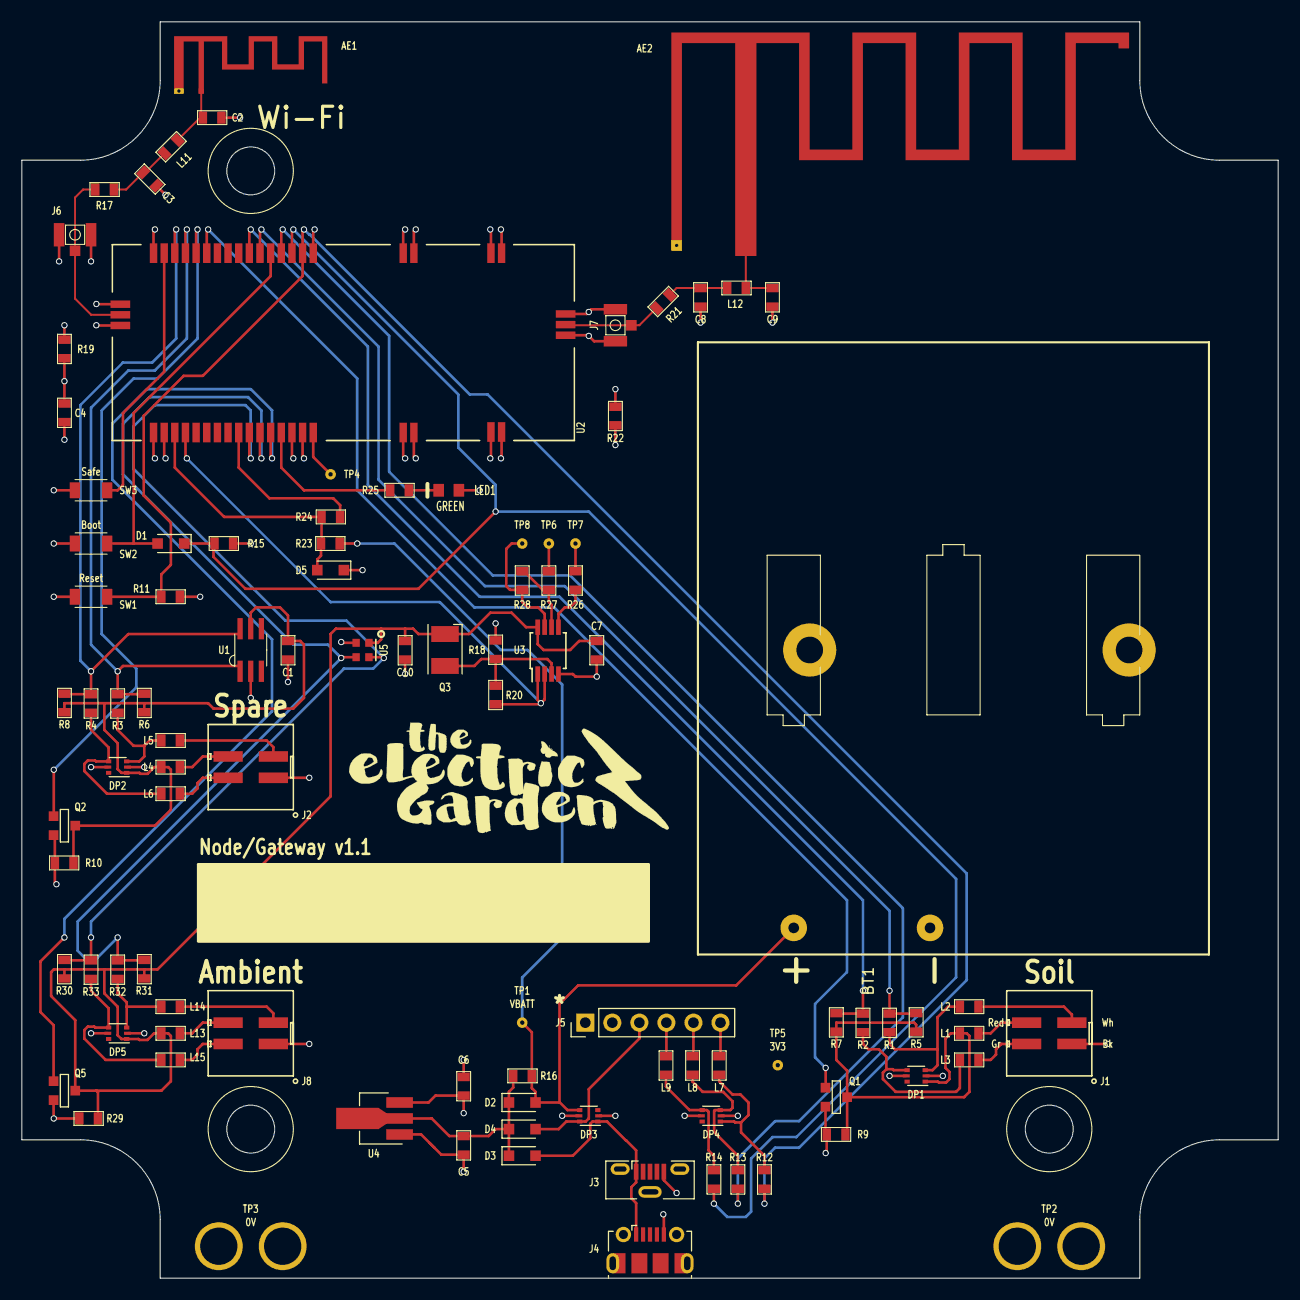
[picture p17: board eg_node+boxco-1313.kicad_pcb from above]

Board: 4 copper layers, 118.0 x 118.0 mm, 105 parts (0 on the bottom side), 64 nets.
