CodeClubTeam/ElectricGarden/Repositories/electricgarden-eg_node_and_gateway_firmware-aa23058780e1/sensornode/lopy-src/sensors/LightSensor.py

from .Analog import Analog
class LightSensor(Analog):

    name = "Light sensor"
    description = "On-Board ElectricGarden light sensor"

    def __init__(self, analog_pin):
        Analog.__init__(self, analog_pin)
