CodeClubTeam/ElectricGarden/Repositories/electricgarden-electricgardenfirmware-3cf1cbd7a6ae/provisioning/mp/mpfexp.py

##
# The MIT License (MIT)
#
# Copyright (c) 2016 Stefan Wendler
#
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
# THE SOFTWARE IS PROVIDED "AS IS", WITHOUT WARRANTY OF ANY KIND, EXPRESS OR
# IMPLIED, INCLUDING BUT NOT LIMITED TO THE WARRANTIES OF MERCHANTABILITY,
# FITNESS FOR A PARTICULAR PURPOSE AND NONINFRINGEMENT. IN NO EVENT SHALL THE
# AUTHORS OR COPYRIGHT HOLDERS BE LIABLE FOR ANY CLAIM, DAMAGES OR OTHER
# LIABILITY, WHETHER IN AN ACTION OF CONTRACT, TORT OR OTHERWISE, ARISING FROM,
# OUT OF OR IN CONNECTION WITH THE SOFTWARE OR THE USE OR OTHER DEALINGS IN
# THE SOFTWARE.
##


import os
import re
import sre_constants
import binascii
import getpass
import logging
import subprocess
import ast

from mp.pyboard import Pyboard
from mp.pyboard import PyboardError
from mp.conserial import ConSerial
from mp.contelnet import ConTelnet
from mp.conwebsock import ConWebsock
from mp.conbase import ConError
from mp.retry import retry


def _was_file_not_existing(exception):
    """
    Helper function used to check for ENOENT (file doesn't exist),
    ENODEV (device doesn't exist, but handled in the same way) or
    EINVAL errors in an exception. Treat them all the same for the
    time being. TODO: improve and nuance.

    :param  exception:      exception to examine
    :return:                True if non-existing
    """

    stre = str(exception)
    return any(err in stre for err in ('ENOENT', 'ENODEV', 'EINVAL', 'OSError:'))


class RemoteIOError(IOError):
    pass


class MpFileExplorer(Pyboard):

    BIN_CHUNK_SIZE = 64
    MAX_TRIES = 3

    def __init__(self, constr, reset=False):
        """
        Supports the following connection strings.

            ser:/dev/ttyUSB1,<baudrate>
            tn:192.168.1.101,<login>,<passwd>
            ws:192.168.1.102,<passwd>

        :param constr:      Connection string as defined above.
        """

        self.reset = reset

        try:
            Pyboard.__init__(self, self.__con_from_str(constr))
        except Exception as e:
            raise ConError(e)

        self.dir = None
        self.sysname = None
        self.setup()

    def __del__(self):

        try:
            self.exit_raw_repl()
        except:
            pass

        try:
            self.close()
        except:
            pass

    def __con_from_str(self, constr):

        con = None

        proto, target = constr.split(":")
        params = target.split(",")

        if proto.strip(" ") == "ser":
            port = params[0].strip(" ")

            if len(params) > 1:
                baudrate = int(params[1].strip(" "))
            else:
                baudrate = 115200

            con = ConSerial(port=port, baudrate=baudrate, reset=self.reset)

        elif proto.strip(" ") == "tn":

            host = params[0].strip(" ")

            if len(params) > 1:
                login = params[1].strip(" ")
            else:
                print("")
                login = input("telnet login : ")

            if len(params) > 2:
                passwd = params[2].strip(" ")
            else:
                passwd = getpass.getpass("telnet passwd: ")

            # print("telnet connection to: %s, %s, %s" % (host, login, passwd))
            con = ConTelnet(ip=host, user=login, password=passwd)

        elif proto.strip(" ") == "ws":

            host = params[0].strip(" ")

            if len(params) > 1:
                passwd = params[1].strip(" ")
            else:
                passwd = getpass.getpass("webrepl passwd: ")

            con = ConWebsock(host, passwd)

        return con

    def _fqn(self, name):
        return os.path.join(self.dir, name)

    def __set_sysname(self):
        self.sysname = self.eval("os.uname()[0]").decode('utf-8')

    def close(self):

        Pyboard.close(self)
        self.dir = None

    def teardown(self):

        self.exit_raw_repl()
        self.sysname = None

    def setup(self):

        self.enter_raw_repl()
        self.exec_("import os, sys, ubinascii")

        # New version mounts files on /flash so lets set dir based on where we are in
        # filesystem.
        # Using the "path.join" to make sure we get "/" if "os.getcwd" returns "".
        self.dir = os.path.join("/", self.eval("os.getcwd()").decode('utf8'))

        self.__set_sysname()

    @retry(PyboardError, tries=MAX_TRIES, delay=1, backoff=2, logger=logging.root)
    def ls(self, add_files=True, add_dirs=True, add_details=False):

        files = []

        try:

            res = self.eval("os.listdir('%s')" % self.dir)
            tmp = ast.literal_eval(res.decode('utf-8'))

            if add_dirs:
                for f in tmp:
                    try:

                        # if it is a dir, it could be listed with "os.listdir"
                        self.eval("os.listdir('%s/%s')" % (self.dir.rstrip('/'), f))
                        if add_details:
                            files.append((f, 'D'))
                        else:
                            files.append(f)

                    except PyboardError as e:

                        if _was_file_not_existing(e):
                            # this was not a dir
                            if self.sysname == "WiPy" and self.dir == "/":
                                # for the WiPy, assume that all entries in the root of th FS
                                # are mount-points, and thus treat them as directories
                                if add_details:
                                    files.append((f, 'D'))
                                else:
                                    files.append(f)
                        else:
                            raise e

            if add_files and not (self.sysname == "WiPy" and self.dir == "/"):
                for f in tmp:
                    try:

                        # if it is a file, "os.listdir" must fail
                        self.eval("os.listdir('%s/%s')" % (self.dir.rstrip('/'), f))

                    except PyboardError as e:

                        if _was_file_not_existing(e):
                            if add_details:
                                files.append((f, 'F'))
                            else:
                                files.append(f)
                        else:
                            raise e

        except Exception  as e:
            if _was_file_not_existing(e):
                raise RemoteIOError("No such directory: %s" % self.dir)
            else:
                raise PyboardError(e)

        return files

    @retry(PyboardError, tries=MAX_TRIES, delay=1, backoff=2, logger=logging.root)
    def rm(self, target):

        try:
            # 1st try to delete it as a file
            self.eval("os.remove('%s')" % (self._fqn(target)))
        except PyboardError as e:
            try:
                # 2nd see if it is empty dir
                self.eval("os.rmdir('%s')" % (self._fqn(target)))
            except PyboardError as e:
                # 3rd report error if nor successful
                if _was_file_not_existing(e):
                    if self.sysname == "WiPy":
                        raise RemoteIOError("No such file or directory or directory not empty: %s" % target)
                    else:
                        raise RemoteIOError("No such file or directory: %s" % target)
                elif "EACCES" in str(e):
                    raise RemoteIOError("Directory not empty: %s" % target)
                else:
                    raise e

    def mrm(self, pat, verbose=False):

        files = self.ls(add_dirs=False)
        find = re.compile(pat)

        for f in files:
            if find.match(f):
                if verbose:
                    print(" * rm %s" % f)

                self.rm(f)

    @retry(PyboardError, tries=MAX_TRIES, delay=1, backoff=2, logger=logging.root)
    def put(self, src, dst=None):

        f = open(src, "rb")
        data = f.read()
        f.close()

        if dst is None:
            dst = src

        try:

            self.exec_("f = open('%s', 'wb')" % self._fqn(dst))
            self.exec_("""def wwv(blob, verify):
                            if sum(blob) != verify:
                              raise OSError('Failed to verify blob')
                            f.write(blob)
                       """)
            while True:
                c = binascii.hexlify(data[:self.BIN_CHUNK_SIZE])
                verify = sum(data[:self.BIN_CHUNK_SIZE])
                if not len(c):
                    break

                self.exec_("wwv(ubinascii.unhexlify('%s', %i))" % (c.decode('utf-8'), verify))
                data = data[self.BIN_CHUNK_SIZE:]

            self.exec_("f.close()")

        except PyboardError as e:
            if _was_file_not_existing(e):
                raise RemoteIOError("Failed to create file: %s" % dst)
            elif "EACCES" in str(e):
                raise RemoteIOError("Existing directory: %s" % dst)
            else:
                raise e

    def mput(self, src_dir, pat, verbose=False):

        try:

            find = re.compile(pat)
            files = os.listdir(src_dir)

            for f in files:
                if os.path.isfile(f) and find.match(f):
                    if verbose:
                        print(" * put %s" % f)

                    self.put(os.path.join(src_dir, f), f)

        except sre_constants.error as e:
            raise RemoteIOError("Error in regular expression: %s" % e)

    @retry(PyboardError, tries=MAX_TRIES, delay=1, backoff=2, logger=logging.root)
    def get(self, src, dst=None):

        if src not in self.ls():
            raise RemoteIOError("No such file or directory: '%s'" % self._fqn(src))

        if dst is None:
            dst = src

        f = open(dst, "wb")

        try:

            self.exec_("f = open('%s', 'rb')" % self._fqn(src))
            ret = self.exec_(
                "while True:\r\n"
                "  c = ubinascii.hexlify(f.read(%s))\r\n"
                "  if not len(c):\r\n"
                "    break\r\n"
                "  sys.stdout.write(c)\r\n" % self.BIN_CHUNK_SIZE
            )

        except PyboardError as e:
            if _was_file_not_existing(e):
                raise RemoteIOError("Failed to read file: %s" % src)
            else:
                raise e

        f.write(binascii.unhexlify(ret))
        f.close()

    def mget(self, dst_dir, pat, verbose=False):

        try:

            files = self.ls(add_dirs=False)
            find = re.compile(pat)

            for f in files:
                if find.match(f):
                    if verbose:
                        print(" * get %s" % f)

                    self.get(f, dst=os.path.join(dst_dir, f))

        except sre_constants.error as e:
            raise RemoteIOError("Error in regular expression: %s" % e)

    @retry(PyboardError, tries=MAX_TRIES, delay=1, backoff=2, logger=logging.root)
    def gets(self, src):

        try:

            self.exec_("f = open('%s', 'rb')" % self._fqn(src))
            ret = self.exec_(
                "while True:\r\n"
                "  c = ubinascii.hexlify(f.read(%s))\r\n"
                "  if not len(c):\r\n"
                "    break\r\n"
                "  sys.stdout.write(c)\r\n" % self.BIN_CHUNK_SIZE
            )

        except PyboardError as e:
            if _was_file_not_existing(e):
                raise RemoteIOError("Failed to read file: %s" % src)
            else:
                raise e

        try:

            return binascii.unhexlify(ret).decode("utf-8")

        except UnicodeDecodeError:

            s = ret.decode("utf-8")
            fs = "\nBinary file:\n\n"

            while len(s):
                fs += s[:64] + "\n"
                s = s[64:]

            return fs

    @retry(PyboardError, tries=MAX_TRIES, delay=1, backoff=2, logger=logging.root)
    def puts(self, dst, lines):

        try:
            if isinstance(lines, bytes):
                data = lines
            else:
                data = lines.encode("utf-8")

            self.exec_("f = open('%s', 'wb')" % self._fqn(dst))
            self.exec_("""def wwv(blob, verify):
                            if sum(blob) != verify:
                              raise OSError('Failed to verify blob')
                            f.write(blob)
                       """)
            
            while True:
                c = binascii.hexlify(data[:self.BIN_CHUNK_SIZE])
                verify = sum(data[:self.BIN_CHUNK_SIZE])
                if not len(c):
                    break
                try:
                    self.exec_("wwv(ubinascii.unhexlify('%s'), %i)" % (c.decode('utf-8'), verify))
                except Exception as e:
                    print(e)
                    print('during wwv')
                    raise e
                data = data[self.BIN_CHUNK_SIZE:]

            self.exec_("f.close()")

        except PyboardError as e:
            if _was_file_not_existing(e):
                raise RemoteIOError("Failed to create file: %s" % dst)
            elif "EACCES" in str(e):
                raise RemoteIOError("Existing directory: %s" % dst)
            else:
                raise e

    @retry(PyboardError, tries=MAX_TRIES, delay=1, backoff=2, logger=logging.root)
    def cd(self, target):

        if target.startswith("/"):
            tmp_dir = target
        elif target == "..":
            tmp_dir, _ = os.path.split(self.dir)
        else:
            tmp_dir = self._fqn(target)

        # see if the new dir exists
        try:

            self.eval("os.listdir('%s')" % tmp_dir)
            self.dir = tmp_dir

        except PyboardError as e:
            if _was_file_not_existing(e):
                raise RemoteIOError("No such directory: %s" % target)
            else:
                raise e

    def pwd(self):
        return self.dir

    @retry(PyboardError, tries=MAX_TRIES, delay=1, backoff=2, logger=logging.root)
    def md(self, target):

        try:

            self.eval("os.mkdir('%s')" % self._fqn(target))

        except PyboardError as e:
            if _was_file_not_existing(e):
                raise RemoteIOError("Invalid directory name: %s" % target)
            elif "EEXIST" in str(e):
                raise RemoteIOError("File or directory exists: %s" % target)
            else:
                raise e

    def mpy_cross(self, src, dst=None):

        if dst is None:
            return_code = subprocess.call("mpy-cross %s" % (src), shell=True)
        else:
            return_code = subprocess.call("mpy-cross -o %s %s" % (src, dst), shell=True)

        if return_code != 0:
            raise IOError("Filed to compile: %s" % src)


class MpFileExplorerCaching(MpFileExplorer):

    def __init__(self, constr, reset=False):
        MpFileExplorer.__init__(self, constr, reset)

        self.cache = {}

    def __cache(self, path, data):

        logging.debug("caching '%s': %s" % (path, data))
        self.cache[path] = data

    def __cache_hit(self, path):

        if path in self.cache:
            logging.debug("cache hit for '%s': %s" % (path, self.cache[path]))
            return self.cache[path]

        return None

    def ls(self, add_files=True, add_dirs=True, add_details=False):

        hit = self.__cache_hit(self.dir)

        if hit is not None:

            files = []

            if add_dirs:
                for f in hit:
                    if f[1] == 'D':
                        if add_details:
                            files.append(f)
                        else:
                            files.append(f[0])

            if add_files:
                for f in hit:
                    if f[1] == 'F':
                        if add_details:
                            files.append(f)
                        else:
                            files.append(f[0])

            return files

        files = MpFileExplorer.ls(self, add_files, add_dirs, add_details)

        if add_files and add_dirs and add_details:
            self.__cache(self.dir, files)

        return files

    def put(self, src, dst=None):

        MpFileExplorer.put(self, src, dst)

        if dst is None:
            dst = src

        path = os.path.split(self._fqn(dst))
        newitm = path[-1]
        parent = path[:-1][0]

        hit = self.__cache_hit(parent)

        if hit is not None:
            if not (dst, 'F') in hit:
                self.__cache(parent, hit + [(newitm, 'F')])

    def puts(self, dst, lines):

        MpFileExplorer.puts(self, dst, lines)

        path = os.path.split(self._fqn(dst))
        newitm = path[-1]
        parent = path[:-1][0]

        hit = self.__cache_hit(parent)

        if hit is not None:
            if not (dst, 'F') in hit:
                self.__cache(parent, hit + [(newitm, 'F')])

    def md(self, dir):

        MpFileExplorer.md(self, dir)

        path = os.path.split(self._fqn(dir))
        newitm = path[-1]
        parent = path[:-1][0]

        hit = self.__cache_hit(parent)

        if hit is not None:
            if not (dir, 'D') in hit:
                self.__cache(parent, hit + [(newitm, 'D')])

    def rm(self, target):

        MpFileExplorer.rm(self, target)

        path = os.path.split(self._fqn(target))
        rmitm = path[-1]
        parent = path[:-1][0]

        hit = self.__cache_hit(parent)

        if hit is not None:
            files = []

            for f in hit:
                if f[0] != rmitm:
                    files.append(f)

            self.__cache(parent, files)
