CodeClubTeam/ElectricGarden/(notices)

Notices in the files:
Repositories/electricgarden-lte_catm1-6e474109b6a4/provisioning/custom_firmware/src/flash/gateway/crc16pure.py:
This program is free software: you can redistribute it and/or modify
it under the terms of the GNU Lesser General Public License as published by
the Free Software Foundation, either version 3 of the License, or
(at your option) any later version.
Repositories/electricgarden-lte_catm1-6e474109b6a4/provisioning/esptool.py:
This program is free software; you can redistribute it and/or modify it under
the terms of the GNU General Public License as published by the Free Software
